Mikrocontroller-net/transistortester/Hardware/ArduinoUno_shield/ArduinoUno_TTshield_back.JPG

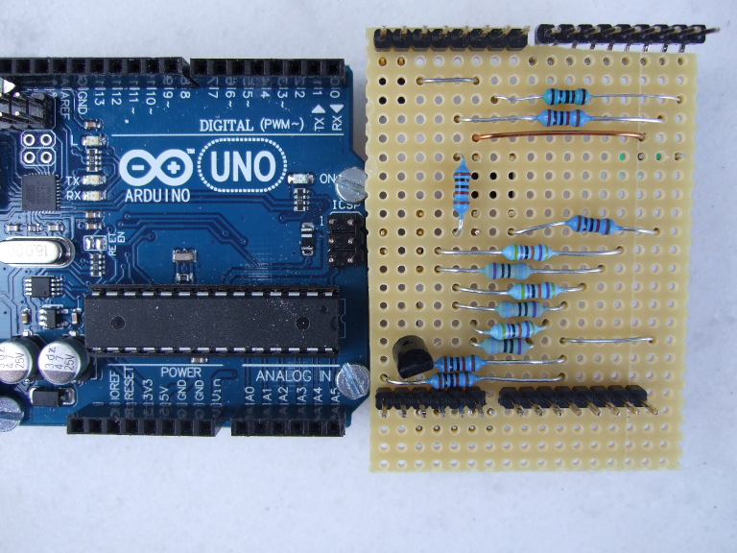
Hardware/ArduinoUno_shield/ArduinoUno_TTshield_back.JPG
