Mikrocontroller-net/transistortester/Hardware/ArduinoUno_shield/ArduinoUno_TTshield_front.JPG

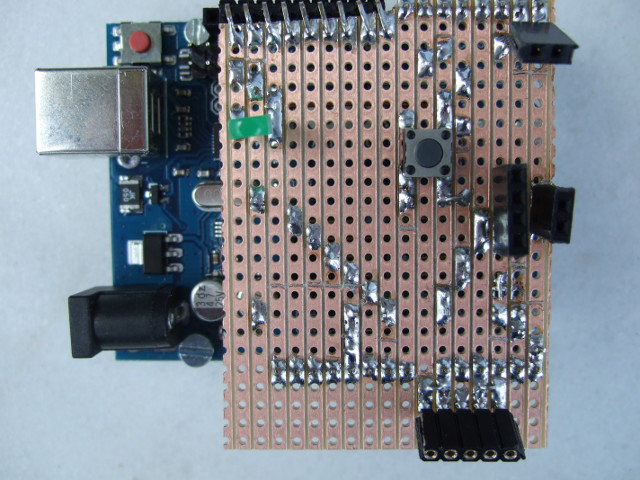
Hardware/ArduinoUno_shield/ArduinoUno_TTshield_front.JPG
