Mikrocontroller-net/transistortester/Doku/tags/README.md

All old documentation files are removed here!

You can find them now at github.com/kubi48/TransistorTester-old-versions !
