Mikrocontroller-net/transistortester/Hardware/Max/LiesMich.txt

Ich habe mit Fritzing ein einseitiges Platinenlayout erstellt und mir 
eine Platine geätzt. Nachdem das ganze jetzt tadellos funktioniert 
wollte ich das anderen Anfängern gerne zugänglich machen. Wenn das 
gewünscht ist darf es natürlich auch gerne in das SVN aufgenommen 
werden.

Q1 ist lediglich ein Platzhalter für die Spannungsreferenz, die fritzing 
nicht kannte.

Gruß Max
