Mikrocontroller-net/transistortester/Software/trunk/mega168_3.3V/LiesMich.txt

Diese Konfiguration ist vorgesehen für die ATmega168 Version
des Testers mit DC-DC Converter-Betrieb aus einem LiIon Akkumulator.
Die untere Spannungsgrenze von 3.3V sollte einen Defekt des Akkus
durch Tiefentladung verhindern!
Als Anzeige wird ein 2x16 Zeichen Textdisplay verwendet.
Die Schaltung wurde von Funkamateuren im Rahmen des Fichtenfieldday 2013
entwickelt (http://www.o28.sischa.net/fifiprojekte/44-mini-bauteiltester).
