Mikrocontroller-net/transistortester/Software/picture-link.pdf

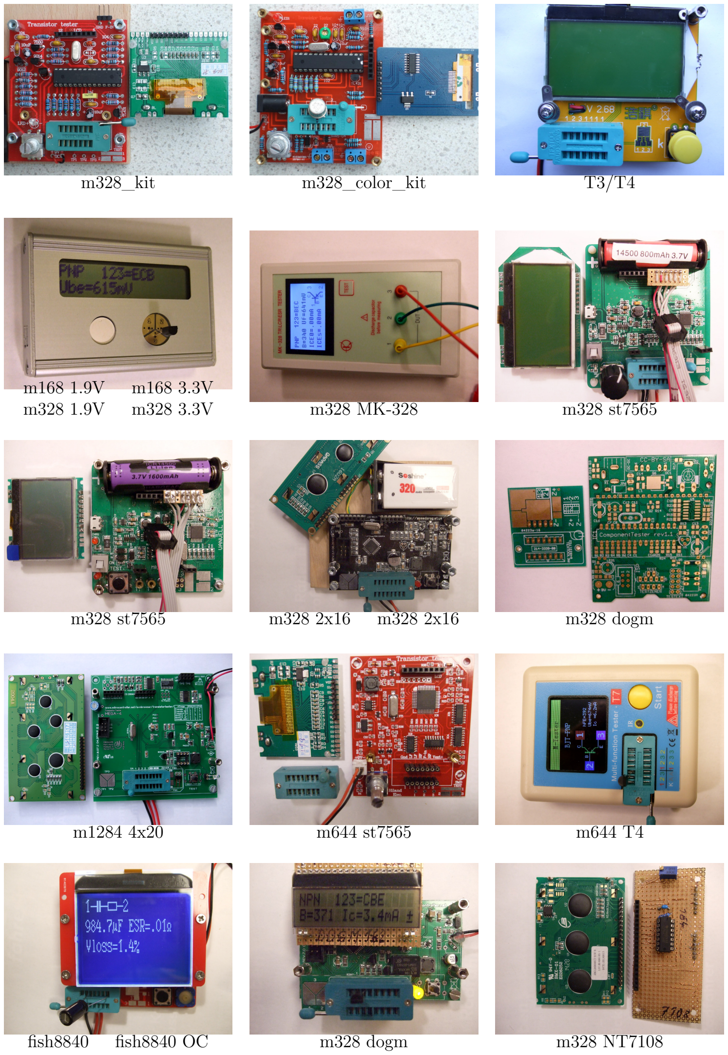
[picture p3: page 1]

m328_kit | m328_color_kit | T3/T4
m168 1.9V | m168 3.3V
m328 1.9V | m328 3.3V | m328 MK-328 | m328 st7565
m328 st7565 | m328 2x16 | m328 2x16 | m328 dogm
m1284 4x20 | m644 st7565 | m644 T4
fish8840 | fish8840 OC | m328 dogm | m328 NT7108
