Mikrocontroller-net/transistortester/Software/trunk/mega168_strip_grid/LiesMich.txt

Achtung, diese Version aktiviert eine andere Pinbelegung für den Anschluss des LC-Displays.
Auf keinen Fall für eine Leiterplatte mit Standard-Belegung der Port D Pins benutzen!
