Mikrocontroller-net/transistortester/Hardware/Max/fritzing_diagram.png

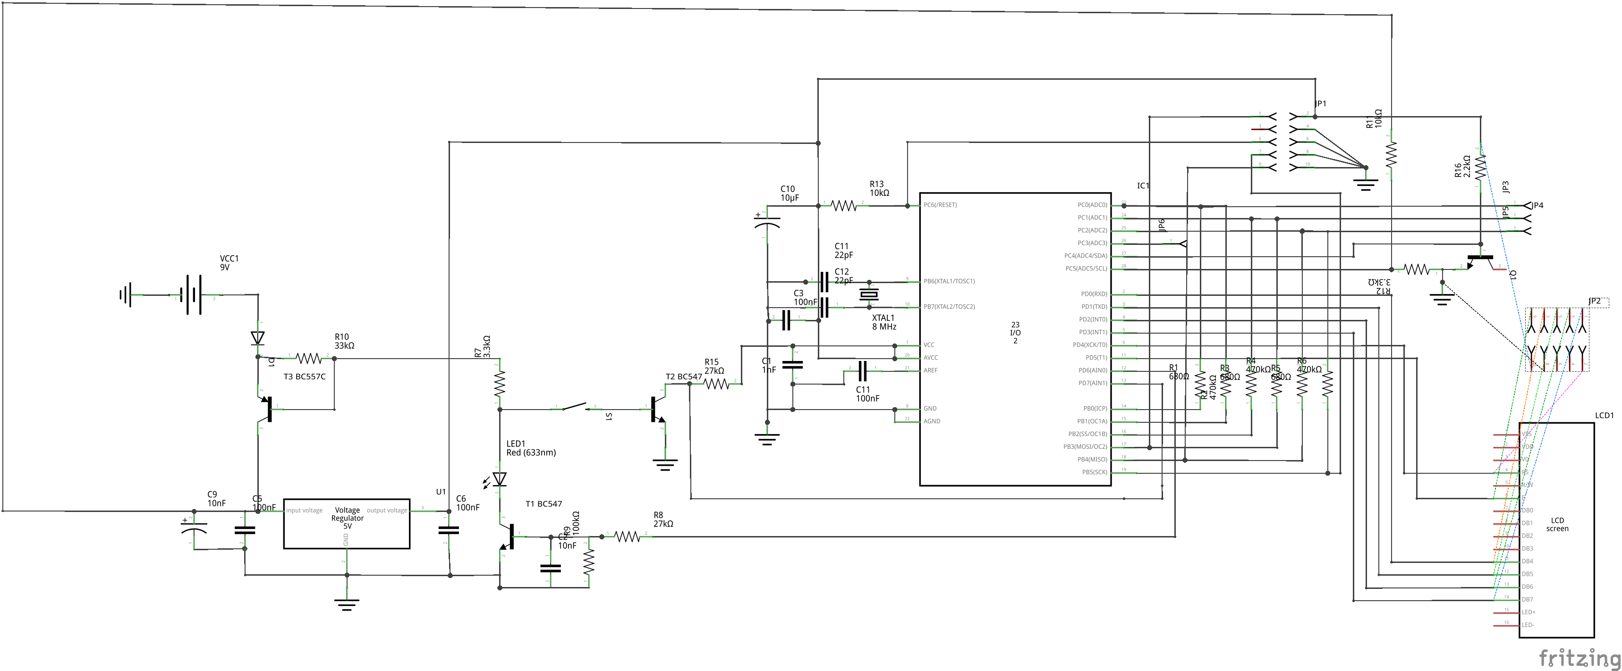
Hardware/Max/fritzing_diagram.png
