Mikrocontroller-net/transistortester/Hardware/PCB_mega328_ST7735/pcb AVR-Transistor tester.pdf

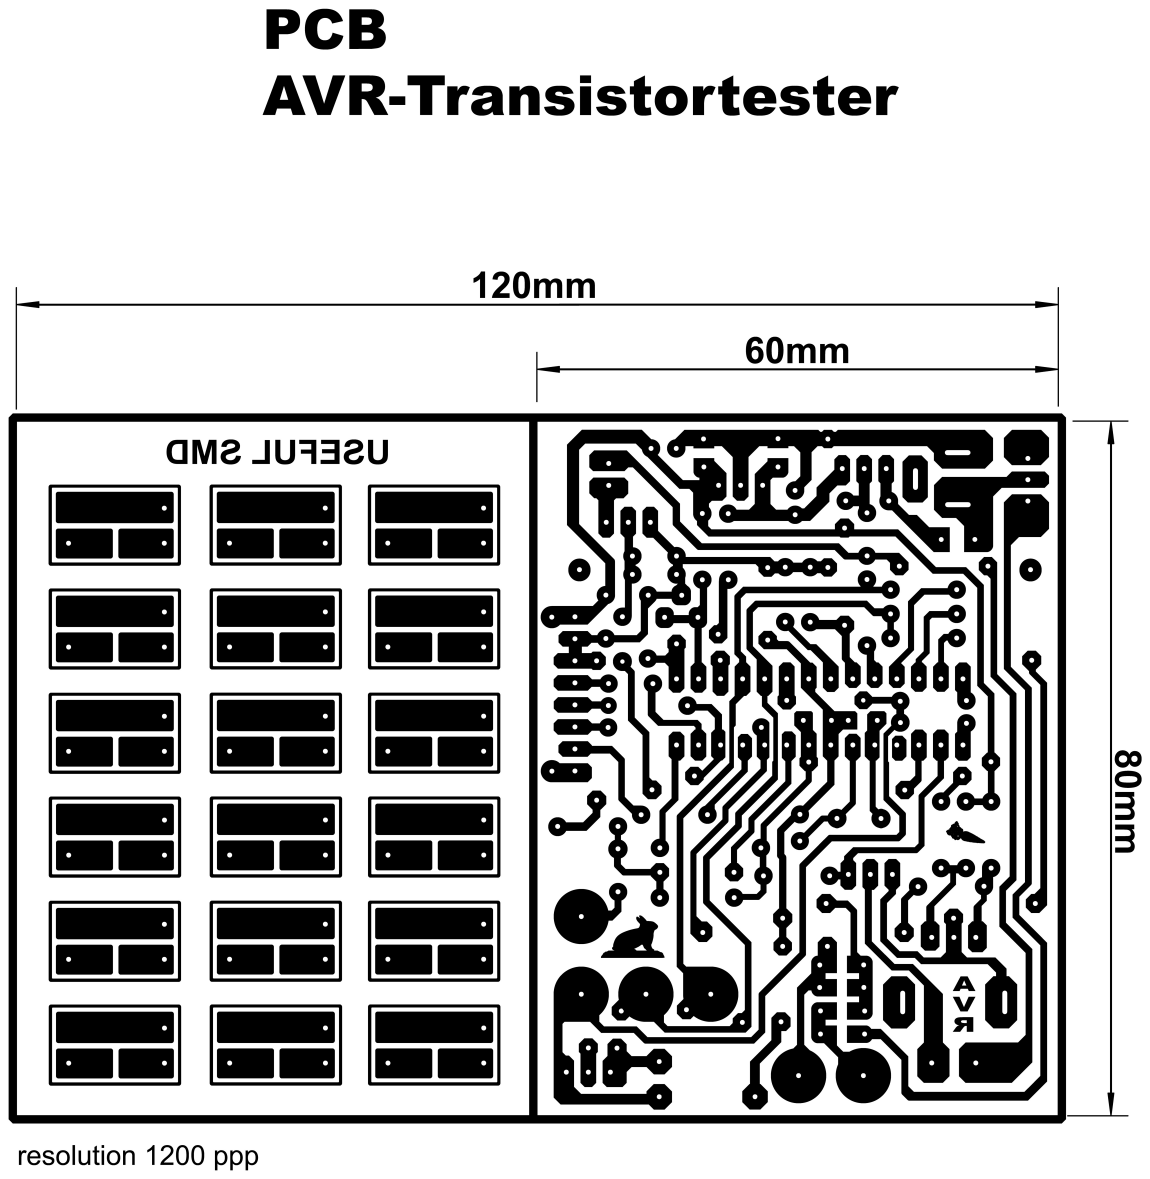
[picture p227: page 1]
