Mikrocontroller-net/transistortester/(threads)

Thread 2 (2021-05-07):

Guide for noob

0x0L, 2021-05-07:
Hello,

Thanks for this cool project!

I recently bought an LCR T4 and was really hopping to be able to upgrade the firmware using an Arduino Nano.
Is this something that's do-able or do I need some other card or even a dedicated usb programmer ?

Many thanks

kubi48, 2021-05-07:
Hallo,

there are two versions of this T4 tester that differ in the display connection.

You can find precompiled hex and eep files in the

directories Software/trunk/mega328_T3_T4_st7565 and Software/trunk/Mega328_T4_v2_st7565.

Of course you can use a Arduino Nano or Arduino UNO to update the T4 Tester with the

ISP-Programmer sample application.

But you can use also a USBASP AVR programmer  with a 10pin to 6-pin adapter or a

Pololu USB AVR Programmer, which has a additional USB-serial interface at the

same board.

Please note, that the standard configuration of the open source Software enables

the SamplingADC feature of Pieter-Tjerk.

With that feature the tester can measure small coils too,

if you connect a capacitor (10nf - 30nF) parallel to build a resonant circuit.

For this purpose, the calibration process was expanded to include the measurement of this capacitor.

Please use a high quality capacitor for this feature (low inductance capacitor)

to get proper inductance measurements.

There are some helpfull scripts too install the Transistortester Software

with Linux (tested with Linux Mint) at

github.com/kubi48/TransistorTester-Linux-install

Best regards,

Kark-Heinz

Gesendet: Freitag, 07. Mai 2021 um 12:41 Uhr
Von: "nullptr" ***@***.***>
An: "Mikrocontroller-net/transistortester" ***@***.***>
Cc: "Subscribed" ***@***.***>
Betreff: [Mikrocontroller-net/transistortester] Guide for noob (#2)

Hello,

Thanks for this cool project!

I recently bought an LCR T4 and was really hopping to be able to upgrade the firmware using an Arduino Nano.
Is this something that's do-able or do I need some other card or even a dedicated usb programmer ?

Many thanks

—
You are receiving this because you are subscribed to this thread.
Reply to this email directly, view it on GitHub, or unsubscribe.

0x0L, 2021-05-07:
Thank you very much for your answers!
Best regards

Closed 2021-05-07.

Thread 5 (2021-08-03):

Menu exit time

zhqsoft, 2021-08-03:
How to modify the auto exit waiting time under the menu interface? Now it takes 1400 seconds. It's too long. I didn't find the relevant settings in the source code.

pav1388, 2021-08-03:
File function_menu.c
Find ii = wait_for_key_ms(SHORT_WAIT_TIME);
Replace ii = wait_for_key_ms(200);
It turns out about 30 seconds.  Two years ago it definitely worked.

zhqsoft, 2021-08-03:
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

非常感谢，已经成功了。替换成200，无操作1分钟自动退出

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

Thank you very much. It has been successful. Replace with 200 and exit automatically after 1 minute without operation。

zhqsoft, 2021-08-03:
200 will lead to abnormal key function. It takes at least 1000, but it takes too long

Thread 8 (2022-12-08):

How i can get an negative picture on LCR-T4

porlock, 2022-12-08:
I switch a screen on my LCR-T4 to blue backlight one, but black letters on blue background are almost invisible :( is there a way how i can make a display in negative ?
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

kubi48, 2022-12-10:
Hello Tomasz,

There is no way supported by the "k" software version, that the pixels

 of  the display can be shown inverted.

Probably you can try to find a better contrast value in the menu (Contrast).

But you should know, that the contrast value is decreased by a short key press

and increased by a longer (>0.5 s) key press. A very long key press will save the value.

If the contrast value is changed to a wrong value, the content of the display is unvisible!

Sometimes the content is visible with a look from the side to the display.

Otherwise you can try to press the key many times with short presses to get a visible

value. If a wrong value is saved by the very long key press, there is no way to read the

menu again. You must reprogram the ATmega to reset the contrast value to the default value.

You can also change the start value in the Makefile (CFLAGS += -DVOLUME_VALUE=48)

and recompile the software.

Best regards,

Karl-Heinz

Gesendet: Donnerstag, 08. Dezember 2022 um 18:21 Uhr
Von: "Tomasz Zieliński" ***@***.***>
An: "Mikrocontroller-net/transistortester" ***@***.***>
Cc: "Subscribed" ***@***.***>
Betreff: [Mikrocontroller-net/transistortester] How i can get an negative picture on LCR-T4 (Issue #8)

I switch a screen on my LCR-T4 to blue backlight one, but black letters on blue background are almost invisible :( is there a way how i can make a display in negative ?

—
Reply to this email directly, view it on GitHub, or unsubscribe.
You are receiving this because you are subscribed to this thread.Message ID: ***@***.***>

Thread 10 (2023-06-21):

Use avr-gcc built-in F_CPU instead of custom OP_MHZ option

powerbroker, 2023-06-21:
with built-in F-CPU value OP_MHZ can be easily calculated as 'F_CPU / 1000000' and is redundant as a separate setting.

just replace it with F_CPU so user has less headache when configures CPU frequency.

Thread 9 (2023-06-21):

Separate project configuration and build system

powerbroker, 2023-06-21:
there are configuration subfolders in the /transistortester/software/trunk, e.g. 'mega328_MK-328', 'mega644_LCD2004' and so on, containing 'Makefile', specific for each configuration.
there are lots of configuration settings in the config-specific 'Makefile's, and a short build procedure definition. the most of settings are in form of compiler flags, defining macros.

it's extremely hard to enforce proper code assistance and to build project from sources within IDE(with it's own build procedure).

would be great to have configuration setting inside some header file, like default "avr/io.h" is done. depending on project's 'MCU Type' it includes corresponding IO definition header, e.g. 'avr/iom328p.h' in case of 'ATmega328P' or 'ATmega328'.
this way, 'to build the project user just include e.g. 'config.h', which in case of 'st7565_kit' includes default 'st7565_kit.h', in case of 'GM328' - default 'gm328.h', in case of custom schematics - 'custom.h'

Thread 12 (2023-06-22):

Support PCF8814-based Nokla 1110i LCD

powerbroker, 2023-06-22:
Nokla 1110i LCD connected as following:
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

code compiled with 'WITH_LCD_ST7565 = 8814' and 'LCD_INTERFACE_MODE=3'.

to force the LCD to work finally, void lcd_init() in lcd-routines.c muzz be patched(changes marked with 'Nokla-1110i support' comment):

`#elif (LCD_ST_TYPE == 8814)
   uint8_t volume;

   //Nokla-1110i support
   HW_LCD_CE_PORT &=~(1<<HW_LCD_CE_PIN); 		// CS => 0
   HW_LCD_RES_PORT &=~(1<<HW_LCD_RES_PIN);	// RST => 0
   wait_about10ms();							// wait 5ms or may fail
   HW_LCD_RES_PORT|=(1<<HW_LCD_RES_PIN);		// RST => 1

   lcd_command(0xE2);							// CMD_INTERNAL_RESET
   wait_about50ms();
   //END-OF Nokla-1110i support

   volume = eeprom_read_byte(&EE_Volume_Value);		// read Vop
   lcd_command(CMD_SET_VOP_UPPER | ((volume >> 5) & 0x07));	// set upper Vop
   lcd_command(CMD_SET_VOP_LOWER | (volume & 0x1f));	// set lower Vop
   lcd_command(CMD_SET_START_LINE | (LCD_ST7565_Y_START & 0x3f));       // Set the Start line 0
   lcd_command(CMD_SET_ALLPTS_NORMAL);		// 0xa4 set display to normal

   //Nokla-1110i support
   //lcd_command(CMD_SET_POWER_CONTROL | 4);	// 0x28|4 Charge Pump ON
   lcd_command(CMD_SET_POWER_CONTROL | 7);	// 0x2F !!! Charge Pump ON
   lcd_command(CMD_SET_START_LINE | (LCD_ST7565_Y_START & 0x3f));       // 0x40 Set the Start line 0
   //END-OF Nokla-1110i support

   lcd_command(CMD_SET_COM_REVERSE);		// 0xc8
   lcd_command(CMD_SET_COM_NORMAL);		// 0xc0 set normal Y orientation
   lcd_command(0xa1);				// set MX, X orientation, is pad selectet!
   lcd_command(0xaa);				// set horizontal mode
   lcd_command(0xac);				// set initial row
   lcd_command(0x08);				// initial row = 8  (0-7)
   lcd_clear();
   lcd_command(CMD_DISPLAY_ON);			// 0xaf Display on
   lcd_set_cursor(0,0);`

Thread 13 (2023-10-30):

XTAL not compiling

wrobeleczek, 2023-10-30:
Project: mega328_color_kit
After enabling flag DWITH_XTAL and setting OP MHZ = 16 and WITH_SamplingADC = 1, compilation fails with error:
/usr/lib/gcc/avr/5.4.0/../../../avr/bin/ld: ../Obj/mega328_color_kit/mega328_color_kit.elf section `.text' will not fit in region `text'
/usr/lib/gcc/avr/5.4.0/../../../avr/bin/ld: region `text' overflowed by 1706 bytes

Would You like to tell me it is bug or I do someting wrong?

kubi48, 2023-10-31:
Probably you use a too old avr-gcc compiler.

You can check your compiler version with the command:

avr-gcc -v

The compiler must optimize the code very well to fit this configuration (color-display).

Please make shure, that you use the avr-gcc with version 7.3.0 !

You can find this compiler at:

www.microchip.com/en-us/tools-resources/develop/microchip-studio/gcc-compilers

Best regards,

Karl-Heinz

Gesendet: Montag, 30. Oktober 2023 um 18:56 Uhr
Von: "wrobeleczek" ***@***.***>
An: "Mikrocontroller-net/transistortester" ***@***.***>
Cc: "Subscribed" ***@***.***>
Betreff: [Mikrocontroller-net/transistortester] XTAL not compiling (Issue #13)

Project: mega328_color_kit
After enabling flag DWITH_XTAL and setting OP MHZ = 16 and WITH_SamplingADC = 1, compilation fails with error:
/usr/lib/gcc/avr/5.4.0/../../../avr/bin/ld: ../Obj/mega328_color_kit/mega328_color_kit.elf section .text' will not fit in region text'
/usr/lib/gcc/avr/5.4.0/../../../avr/bin/ld: region `text' overflowed by 1706 bytes

Would You like to tell me it is bug or I do someting wrong?

—
Reply to this email directly, view it on GitHub, or unsubscribe.
You are receiving this because you are subscribed to this thread.Message ID: ***@***.***>

Ho-Ro, 2023-10-31:
> Please make shure, that you use the avr-gcc with version 7.3.0 !

You can also use version `8.3.0` - see my [comparison of different versions](https://www.eevblog.com/forum/testgear/$20-lcr-esr-transistor-checker-project/msg5054215/#msg5054215).

Do not compile the toolchain on your own, `7.3.0` comes with the Arduino 1.x download for Linux and you can download the `8.3.0` binaries for Linux from
[ZakKemble's github](https://github.com/ZakKemble/avr-gcc-build/releases), especially from this link:
- [avr-gcc-8.3.0-x64-linux.tar.bz2](https://github.com/ZakKemble/avr-gcc-build/releases/download/v8.3.0-1/avr-gcc-8.3.0-x64-linux.tar.bz2)

You can also use the latest 13.2.0, it compiles much smaller again after the byte-hogs 9.x.y ... 12.x.y.
- [avr-gcc-13.2.0-1.fc38.x86_64.rpm](https://dl.fedoraproject.org/pub/fedora/linux/updates/38/Everything/x86_64/Packages/a/avr-gcc-13.2.0-1.fc38.x86_64.rpm)

I installed them locally for my user; I untarred the `8.3.0-*.tar.bz2` version and opened the `13.2.0-*.rpm` with the `mc` and copied the files into directories under my home dir, i.e. `~/.local/avr-gcc/avr-gcc-8.3.0` and `~/.local/avr-gcc/avr-gcc-13.2.0` and made softlinks from the avr-gcc binaries to `~/.local/bin/avr-gcc-8` and `~/.local/bin/avr-gcc-13`.

Then you can easily build with different version, just edit the `Makefile`.

HTH
Martin

wrobeleczek, 2023-10-31:
Hi Martin.
Could you tell me exactly which avr-gcc binaries I can add softlinks to?

kubi48, 2023-11-01:
I did unpack the avr8-gnu-toolchain-3.7.0.1796-linux.any.x86_64.tar.gz file

to my home directory ( /home/kub in my case).

After unpacking the avr-gcc is in /home/kub/avr8-gnu-toolchain-linux_x86_64/bin directory.

To replace the standard avr-gcc I have first removed the original compiler with:

sudo rm /usr/bin/avr-gcc

Don't worry about this remove because the same content is in /usr/bin/avr-gcc-5.4.0 .

Then I have installed a softlink to the new compiler:

sudo ln -s /home/kub/avr8-gnu-toolchain-linux_x86_64/bin/avr-gcc /usr/bin/avr-gcc

Of course, You must replace the /home/kub with your home directory name.

This trick works without problems.

Best regards,

Karl-Heinz

Gesendet: Dienstag, 31. Oktober 2023 um 18:03 Uhr
Von: "wrobeleczek" ***@***.***>
An: "Mikrocontroller-net/transistortester" ***@***.***>
Cc: "Karl-Heinz Kübbeler" ***@***.***>, "Comment" ***@***.***>
Betreff: Re: [Mikrocontroller-net/transistortester] XTAL not compiling (Issue #13)

Hi.
Your advice is probably correct (my gcc version 5.4.0 (GCC)).
I downloaded toolchain-avr-master and tried compiled but my knowledge is poor, very poor (like my english, I'm very sorry).
Olny this:
tools.bash
binutils.build.bash
gcc.build.bash
avr-libc.build.bash
compiled OK without fail.
gdb.build.bash -> unfortunately not finished good.
I tried read informations of compilation and noticed:

	checking for python2.7... no
	configure: WARNING: python is missing or unusable; some features may be unavailable
	but:
	whereis python2.7
	python2.7: /usr/bin/python2.7 /usr/lib/python2.7 /etc/python2.7 /usr/local/lib/python2.7 /usr/include/python2.7 /usr/share/man/man1/python2.7.1.gz
	python2.7
	Python 2.7.18 (default, Jul 1 2022, 10:30:50)
	[GCC 11.2.0] on linux2

	hecking whether to use guile... guile-2.0
	checking for pkg-config... /usr/bin/pkg-config
	checking for usable guile from /usr/bin/pkg-config... configure: error: unable to find usable guile version from "guile-2.0"
	make[1]: *** [Makefile:9610: configure-gdb] Fail 1
	but:
	whereis guile
	guile: /usr/bin/guile /usr/lib/x86_64-linux-gnu/guile /usr/share/guile
	GNU Guile 2.0.13
	My OS is Linux Mint 21.2
	Unfortunately, I can't cope with these problems. I don't even know if these errors caused the compilation to fail.

—
Reply to this email directly, view it on GitHub, or unsubscribe.
You are receiving this because you commented.Message ID: ***@***.***>

wrobeleczek, 2023-11-01:
Hi.
In my OS -> echo $PATH
/home/wrobel/.local/bin:/usr/local/sbin:/usr/local/bin:/usr/sbin:/usr/bin:/sbin:/bin:/usr/games:/usr/local/games:/snap/bin

~/.local/bin$ ls -l avr-*
-rwxr-xr-x 1 wrobel wrobel   569352 maj 11  2022 avr-addr2line
-rwxr-xr-x 1 wrobel wrobel   593248 maj 11  2022 avr-ar
-rwxr-xr-x 1 wrobel wrobel   778776 maj 11  2022 avr-as
-rwxr-xr-x 2 wrobel wrobel   920392 maj 11  2022 avr-c++
-rwxr-xr-x 1 wrobel wrobel   567896 maj 11  2022 avr-c++filt
-rwxr-xr-x 1 wrobel wrobel   916296 maj 11  2022 avr-cpp
-rwxr-xr-x 1 wrobel wrobel    24912 maj 11  2022 avr-elfedit
-rwxr-xr-x 2 wrobel wrobel   920392 maj 11  2022 avr-g++
-rwxr-xr-x 2 wrobel wrobel   916296 maj 11  2022 avr-gcc
-rwxr-xr-x 1 wrobel wrobel  1016712 sie 29 02:00 avr-gcc-13.2.0
-rwxr-xr-x 2 wrobel wrobel   916296 maj 11  2022 avr-gcc-7.3.0
-rwxr-xr-x 1 wrobel wrobel    23488 maj 11  2022 avr-gcc-ar
-rwxr-xr-x 1 wrobel wrobel    23456 maj 11  2022 avr-gcc-nm
-rwxr-xr-x 1 wrobel wrobel    23456 maj 11  2022 avr-gcc-ranlib
-rwxr-xr-x 1 wrobel wrobel   549608 maj 11  2022 avr-gcov
-rwxr-xr-x 1 wrobel wrobel   451488 maj 11  2022 avr-gcov-dump
-rwxr-xr-x 1 wrobel wrobel   475136 maj 11  2022 avr-gcov-tool
-rwxr-xr-x 1 wrobel wrobel  5148528 maj 11  2022 avr-gdb
-rwxr-xr-x 1 wrobel wrobel   623640 maj 11  2022 avr-gprof
-rwxr-xr-x 2 wrobel wrobel  1015096 maj 11  2022 avr-ld
-rwxr-xr-x 2 wrobel wrobel  1015096 maj 11  2022 avr-ld.bfd
-rwxr-xr-x 1 wrobel wrobel 23843136 sie 29 02:00 avr-lto-dump
-rwxr-xr-x 1 wrobel wrobel     1908 maj 11  2022 avr-man
-rwxr-xr-x 1 wrobel wrobel   581112 maj 11  2022 avr-nm
-rwxr-xr-x 1 wrobel wrobel   727512 maj 11  2022 avr-objcopy
-rwxr-xr-x 1 wrobel wrobel   836104 maj 11  2022 avr-objdump
-rwxr-xr-x 1 wrobel wrobel   593264 maj 11  2022 avr-ranlib
-rwxr-xr-x 1 wrobel wrobel   415736 maj 11  2022 avr-readelf
-rwxr-xr-x 1 wrobel wrobel   581688 maj 11  2022 avr-size
-rwxr-xr-x 1 wrobel wrobel   572296 maj 11  2022 avr-strings
-rwxr-xr-x 1 wrobel wrobel   727512 maj 11  2022 avr-strip

# compiler flags
CC = avr-gcc-13.2.0
###CPP = avr-g++
OBJCOPY = avr-objcopy-13
OBJDUMP = avr-objdump-13
SIZE = avr-size-13

After compilations:
~/transistortester-master/Software/trunk/mega328_color_kit$ make
rm -rf ../Obj/mega328_color_kit
mkdir -p ../Obj/mega328_color_kit
mkdir -p ../Obj/mega328_color_kit/dep
avr-gcc-13.2.0  -Wall -DWITH_MENU -DWITH_ROTARY_SWITCH=2 -DFOUR_LINE_LCD -DLCD_SCREEN_ROTATE=1 -DLCD_ST7565_H_FLIP=0 -DLCD_ST7565_H_OFFSET=0 -DLCD_ST7565_V_FLIP=1 -DLCD_CHANGE_COLOR=2 -DLCD_BG_COLOR=0x7800 -DLCD_FG_COLOR=0xffff -DLCD_ICON_COLOR=0x03ff -DFONT_8X16thin -DICON_TYPE=3 -DBIG_TP -DWITH_SELFTEST -DAUTO_CAL -DSHORT_UNCAL_MSG -DWITH_XTAL -DWITH_UJT -DWITH_PUT -DFET_Idss -DWITH_AUTO_REF -DREF_C_KORR=12 -DREF_L_KORR=40 -DC_H_KORR=0 -DWITH_VEXT -DRMETER_WITH_L -DCAP_EMPTY_LEVEL=4 -DAUTOSCALE_ADC -DREF_R_KORR=3 -DESR_ZERO=20 -DNO_AREF_CAP -DUSE_EEPROM -DPULLUP_DISABLE -DANZ_MESS=25 -DPOWER_OFF -DBAT_CHECK -DBAT_OUT=150 -DBAT_POOR=6400 -DBAT_NUMERATOR=133 -DBAT_DENOMINATOR=33 -mcall-prologues -I. -DLANG_POLISH -DLCD_ST_TYPE=7735 -DF_CPU=16000000UL -DF_CPU_HZ=16000000 -DMHZ_CPU=16 -mmcu=atmega328p -gdwarf-2 -std=gnu99 -Os -funsigned-char -funsigned-bitfields -fpack-struct -fshort-enums -MD -MP -MT lcd_hw_4_bit.o -MF ../Obj/mega328_color_kit/dep/lcd_hw_4_bit.o.d  -ffunction-sections -fdata-sections -DSamplingADC -c -o ../Obj/mega328_color_kit/lcd_hw_4_bit.o ../lcd_hw_4_bit.S
../lcd_hw_4_bit.S:6:10: fatal error: avr/io.h: No such file or directory
    6 | #include <avr/io.h>
      |          ^~~~~~~~~~
compilation terminated.
make: *** [../finish.mk:14: ../Obj/mega328_color_kit/lcd_hw_4_bit.o] Fail 1

Ho-Ro, 2023-11-01:
Do not *copy* the binaries, just make a softlink to the binaries, (`ln -s ../.../avr-gcc .`) because the `includes` are searched relative to the binaries. Compare your`.local/bin` and mine!

wrobeleczek, 2023-11-02:
Hi.
Now, I understand my mistakes.
The Compilation ends successful.
But when I send .hex to m328p have this:
avrdude -c usbasp -p m328p -U flash:w:mega328_color_kit.hex
avrdude: warning: cannot set sck period. please check for usbasp firmware update.
avrdude: AVR device initialized and ready to accept instructions

Reading | ################################################## | 100% 0.00s

avrdude: Device signature = 0x1e950f (probably m328p)
avrdude: NOTE: "flash" memory has been specified, an erase cycle will be performed
         To disable this feature, specify the -D option.
avrdude: erasing chip
avrdude: warning: cannot set sck period. please check for usbasp firmware update.
avrdude: reading input file "mega328_color_kit.hex"
avrdude: input file mega328_color_kit.hex auto detected as Intel Hex
avrdude: ERROR: address 0x8010 out of range at line 2049 of mega328_color_kit.hex
avrdude: read from file 'mega328_color_kit.hex' failed
avrdude: safemode: Fuses OK (E:FC, H:D9, L:F7)

avrdude done.  Thank you.

When I comment "XTAL" then I can send .hex, .eep without any error.
I noticed:
**(without XTAL)**
16 MHz operation configured.
AVR Memory Usage
----------------
Device: atmega328p
Program:   31952 bytes (97.5% Full)
(.text + .data + .bootloader)
Data:        204 bytes (10.0% Full)
(.data + .bss + .noinit)
EEPROM:      890 bytes (86.9% Full)
(.eeprom)

**(whit XTAL)**
16 MHz operation configured.
AVR Memory Usage
----------------
Device: atmega328p
Program:   34416 bytes (105.0% Full)
(.text + .data + .bootloader)
Data:        212 bytes (10.4% Full)
(.data + .bss + .noinit)
EEPROM:      930 bytes (90.8% Full)
(.eeprom)

Ho-Ro, 2023-11-02:
> The Compilation ends successful.

No!

> Program: 34416 bytes (105.0% Full)

Your resulting hex is too big for the processor- you should omit some other features.

wrobeleczek, 2023-11-02:
What I meant was that the compilation finished correctly (without any previous errors).
So we're back to the beginning.
Apparently, it remains to disable XTAL. :(
My features:
PROJECT = mega328_color_kit
CC = avr-gcc
OBJCOPY = avr-objcopy-13
OBJDUMP = avr-objdump-13
SIZE = avr-size-13
CFLAGS = -Wall
PARTNO = m328p
CFLAGS += -DWITH_MENU
CFLAGS += -DWITH_ROTARY_SWITCH=2
UI_LANGUAGE = LANG_ENGLISH
CFLAGS += -DFOUR_LINE_LCD
WITH_LCD_ST7565 = 7735
LCD_ST7565_RESISTOR_RATIO = 4
CFLAGS += -DLCD_SCREEN_ROTATE=1
CFLAGS += -DLCD_ST7565_H_FLIP=0
CFLAGS += -DLCD_ST7565_H_OFFSET=0
CFLAGS += -DLCD_ST7565_V_FLIP=1
CFLAGS += -DLCD_CHANGE_COLOR=2
CFLAGS += -DLCD_BG_COLOR=0x7800
CFLAGS += -DLCD_FG_COLOR=0xffff
CFLAGS += -DLCD_ICON_COLOR=0x03ff
CFLAGS += -DFONT_8X16thin
CFLAGS += -DICON_TYPE=3
CFLAGS += -DBIG_TP
CFLAGS += -DBIG_TP
CFLAGS += -DAUTO_CAL
CFLAGS += -DSHORT_UNCAL_MSG
WITH_SamplingADC = 1
CFLAGS += -DWITH_XTAL
CFLAGS += -DFET_Idss
CFLAGS += -DWITH_AUTO_REF
CFLAGS += -DREF_C_KORR=12
CFLAGS += -DREF_L_KORR=40
CFLAGS += -DC_H_KORR=0
CFLAGS += -DWITH_VEXT
CFLAGS += -DRMETER_WITH_L
CFLAGS += -DCAP_EMPTY_LEVEL=4
CFLAGS += -DAUTOSCALE_ADC
CFLAGS += -DREF_R_KORR=3
CFLAGS += -DESR_ZERO=20
CFLAGS += -DNO_AREF_CAP
OP_MHZ = 16
CFLAGS += -DUSE_EEPROM
CFLAGS += -DPULLUP_DISABLE
CFLAGS += -DANZ_MESS=25
CFLAGS += -DPOWER_OFF
CFLAGS += -DBAT_CHECK
CFLAGS += -DBAT_OUT=150
CFLAGS += -DBAT_POOR=6400
CFLAGS += -DBAT_NUMERATOR=133
CFLAGS += -DBAT_DENOMINATOR=33
INHIBIT_SLEEP_MODE = 0
PROGRAMMER=usbasp
BitClock=20
PORT=usb
PROGRAMMER=usbasp
include ../setup.mk
$(OBJDIR)/GetRLmultip.o: ../GetRLmultip.S $(MKFILES)
        $(CC) $(INCLUDES) $(CFLAGS) -c -o $@ $<

$(OBJDIR)/UfAusgabe.o: ../UfAusgabe.S $(MKFILES)
        $(CC) $(INCLUDES) $(CFLAGS) -c -o $@ $<

$(OBJDIR)/RvalOut.o: ../RvalOut.S $(MKFILES)
        $(CC) $(INCLUDES) $(CFLAGS) -c -o $@ $<

$(OBJDIR)/PinLayout.o: ../PinLayout.S $(MKFILES)
        $(CC) $(INCLUDES) $(CFLAGS) -c -o $@ $<

$(OBJDIR)/RefVoltage.o: ../RefVoltage.S $(MKFILES)
        $(CC) $(INCLUDES) $(CFLAGS) -c -o $@ $<

$(OBJDIR)/i2lcd.o: ../i2lcd.S $(MKFILES)
        $(CC) $(INCLUDES) $(CFLAGS) -c -o $@ $<

$(OBJDIR)/ReadADC.o: ../ReadADC.S $(MKFILES)
        $(CC) $(INCLUDES) $(CFLAGS) -c -o $@ $<

$(OBJDIR)/sleep_5ms.o: ../sleep_5ms.S $(MKFILES)
        $(CC) $(INCLUDES) $(CFLAGS) -c -o $@ $<

$(OBJDIR)/wait_for_key_ms.o: ../wait_for_key_ms.c $(MKFILES)
        $(CC) $(INCLUDES) $(CFLAGS) -c -o $@ $<

$(OBJDIR)/get_log.o: ../get_log.S $(MKFILES)
        $(CC) $(INCLUDES) $(CFLAGS) -c -o $@ $<

include ../finish.mk
$(NAME): ${OBJECTS}
         ${CC} ${LDFLAGS} ${OBJECTS} ${LIBDIRS} ${LIBS} -o ${NAME}

# create hex file of firmware
%.hex: ${NAME}
        ${OBJCOPY} -O ihex ${HEX_FLASH_FLAGS} $< $@

# create hex file of EEPROM data
%.eep: ${NAME}
        -${OBJCOPY} ${HEX_EEPROM_FLAGS} -O ihex $< $@ || exit 0

# create dump of firmware
%.lss: ${NAME}
        ${OBJDUMP} -h -S $< > $@
# rule for all c-files
${OBJECTS_C}: %.o: %.c ${HEADERS} ${MAKEFILE_LIST}
        ${CC} ${CFLAGS} -c ${@:.o=.c}

# rule for all S-files
${OBJECTS_S}: %.o: %.S ${HEADERS} ${MAKEFILE_LIST}
        ${CC} ${CFLAGS} -c ${@:.o=.S}

When I comment:
CFLAGS += -DWITH_UJT
CFLAGS += -DWITH_PUT
.....
AVR Memory Usage
----------------
Device: atmega328p
Program:   33786 bytes (103.1% Full) -> :(
(.text + .data + .bootloader)
Data:        212 bytes (10.4% Full)
(.data + .bss + .noinit)
EEPROM:      916 bytes (89.5% Full)
(.eeprom)
I don't know what else I can turn off. :(

kubi48, 2023-11-02:
You can Try to remove other features, if you wish to enable XTAL testing with the color display.

I suggest:

CFLAGS += -DNO_TEST_T1_T7

#CFLAGS += -DFET_Idss

If you need the tests T1 to T7 for functional test (error case),

you must deselect the "CFLAGS += -DWITH_XTAL" to

enable the "CFLAGS += -DNO_TEST_T1_T7" .

Otherwise you can try to use a smaller font like:

CFLAGS += -DFONT_6X8
#CFLAGS += -DFONT_8X12thin

Best regards,

Karl-Heinz

Gesendet: Donnerstag, 02. November 2023 um 21:08 Uhr
Von: "wrobeleczek" ***@***.***>
An: "Mikrocontroller-net/transistortester" ***@***.***>
Cc: "Karl-Heinz Kübbeler" ***@***.***>, "Comment" ***@***.***>
Betreff: Re: [Mikrocontroller-net/transistortester] XTAL not compiling (Issue #13)

What I meant was that the compilation finished correctly (without any previous errors).
So we're back to the beginning.
Apparently, it remains to disable XTAL. :(
My features:
PROJECT = mega328_color_kit
CC = avr-gcc
OBJCOPY = avr-objcopy-13
OBJDUMP = avr-objdump-13
SIZE = avr-size-13
CFLAGS = -Wall
PARTNO = m328p
CFLAGS += -DWITH_MENU
CFLAGS += -DWITH_ROTARY_SWITCH=2
UI_LANGUAGE = LANG_ENGLISH
CFLAGS += -DFOUR_LINE_LCD
WITH_LCD_ST7565 = 7735
LCD_ST7565_RESISTOR_RATIO = 4
CFLAGS += -DLCD_SCREEN_ROTATE=1
CFLAGS += -DLCD_ST7565_H_FLIP=0
CFLAGS += -DLCD_ST7565_H_OFFSET=0
CFLAGS += -DLCD_ST7565_V_FLIP=1
CFLAGS += -DLCD_CHANGE_COLOR=2
CFLAGS += -DLCD_BG_COLOR=0x7800
CFLAGS += -DLCD_FG_COLOR=0xffff
CFLAGS += -DLCD_ICON_COLOR=0x03ff
CFLAGS += -DFONT_8X16thin
CFLAGS += -DICON_TYPE=3
CFLAGS += -DBIG_TP
CFLAGS += -DBIG_TP
CFLAGS += -DAUTO_CAL
CFLAGS += -DSHORT_UNCAL_MSG
WITH_SamplingADC = 1
CFLAGS += -DWITH_XTAL
CFLAGS += -DFET_Idss
CFLAGS += -DWITH_AUTO_REF
CFLAGS += -DREF_C_KORR=12
CFLAGS += -DREF_L_KORR=40
CFLAGS += -DC_H_KORR=0
CFLAGS += -DWITH_VEXT
CFLAGS += -DRMETER_WITH_L
CFLAGS += -DCAP_EMPTY_LEVEL=4
CFLAGS += -DAUTOSCALE_ADC
CFLAGS += -DREF_R_KORR=3
CFLAGS += -DESR_ZERO=20
CFLAGS += -DNO_AREF_CAP
OP_MHZ = 16
CFLAGS += -DUSE_EEPROM
CFLAGS += -DPULLUP_DISABLE
CFLAGS += -DANZ_MESS=25
CFLAGS += -DPOWER_OFF
CFLAGS += -DBAT_CHECK
CFLAGS += -DBAT_OUT=150
CFLAGS += -DBAT_POOR=6400
CFLAGS += -DBAT_NUMERATOR=133
CFLAGS += -DBAT_DENOMINATOR=33
INHIBIT_SLEEP_MODE = 0
PROGRAMMER=usbasp
BitClock=20
PORT=usb
PROGRAMMER=usbasp
include ../setup.mk
$(OBJDIR)/GetRLmultip.o: ../GetRLmultip.S $(MKFILES)
$(CC) $(INCLUDES) $(CFLAGS) -c -o $@ $<

$(OBJDIR)/UfAusgabe.o: ../UfAusgabe.S $(MKFILES)
$(CC) $(INCLUDES) $(CFLAGS) -c -o $@ $<

$(OBJDIR)/RvalOut.o: ../RvalOut.S $(MKFILES)
$(CC) $(INCLUDES) $(CFLAGS) -c -o $@ $<

$(OBJDIR)/PinLayout.o: ../PinLayout.S $(MKFILES)
$(CC) $(INCLUDES) $(CFLAGS) -c -o $@ $<

$(OBJDIR)/RefVoltage.o: ../RefVoltage.S $(MKFILES)
$(CC) $(INCLUDES) $(CFLAGS) -c -o $@ $<

$(OBJDIR)/i2lcd.o: ../i2lcd.S $(MKFILES)
$(CC) $(INCLUDES) $(CFLAGS) -c -o $@ $<

$(OBJDIR)/ReadADC.o: ../ReadADC.S $(MKFILES)
$(CC) $(INCLUDES) $(CFLAGS) -c -o $@ $<

$(OBJDIR)/sleep_5ms.o: ../sleep_5ms.S $(MKFILES)
$(CC) $(INCLUDES) $(CFLAGS) -c -o $@ $<

$(OBJDIR)/wait_for_key_ms.o: ../wait_for_key_ms.c $(MKFILES)
$(CC) $(INCLUDES) $(CFLAGS) -c -o $@ $<

$(OBJDIR)/get_log.o: ../get_log.S $(MKFILES)
$(CC) $(INCLUDES) $(CFLAGS) -c -o $@ $<

include ../finish.mk
$(NAME): ${OBJECTS}
${CC} ${LDFLAGS} ${OBJECTS} ${LIBDIRS} ${LIBS} -o ${NAME}

create hex file of firmware

%.hex: ${NAME}
${OBJCOPY} -O ihex ${HEX_FLASH_FLAGS} $&lt; $@

create hex file of EEPROM data

%.eep: ${NAME}
-${OBJCOPY} ${HEX_EEPROM_FLAGS} -O ihex $&lt; $@ || exit 0

create dump of firmware

%.lss: ${NAME}
${OBJDUMP} -h -S $&lt; > $@

rule for all c-files

${OBJECTS_C}: %.o: %.c ${HEADERS} ${MAKEFILE_LIST}
${CC} ${CFLAGS} -c ${@:.o=.c}

rule for all S-files

${OBJECTS_S}: %.o: %.S ${HEADERS} ${MAKEFILE_LIST}
${CC} ${CFLAGS} -c ${@:.o=.S}

When I comment:
CFLAGS += -DWITH_UJT
CFLAGS += -DWITH_PUT
.....
AVR Memory Usage

Device: atmega328p
Program: 33786 bytes (103.1% Full) -> :(
(.text + .data + .bootloader)
Data: 212 bytes (10.4% Full)
(.data + .bss + .noinit)
EEPROM: 916 bytes (89.5% Full)
(.eeprom)
I don't know what else I can turn off. :(

—
Reply to this email directly, view it on GitHub, or unsubscribe.
You are receiving this because you commented.Message ID: ***@***.***>

wrobeleczek, 2023-11-02:
Hi Karl-Heinz.
I changed the font to 5x8 and... success!! :)
...
16 MHz operation configured.
AVR Memory Usage
----------------
Device: atmega328p
Program:   32692 bytes (99.8% Full)
(.text + .data + .bootloader)
Data:        212 bytes (10.4% Full)
(.data + .bss + .noinit)
EEPROM:      922 bytes (90.0% Full)
(.eeprom)

Thx for all. Very Thx.

wrobeleczek, 2023-11-02:
Additionally, I noticed that avr-gcc-8.3.0 has a smaller .hex and .eep file than avr-gcc-7.3.0.

Closed 2023-11-02.
