Mikrocontroller-net/transistortester/Hardware/ArduinoUno_shield/UNO_tester_shield.pdf

10K

## Finp

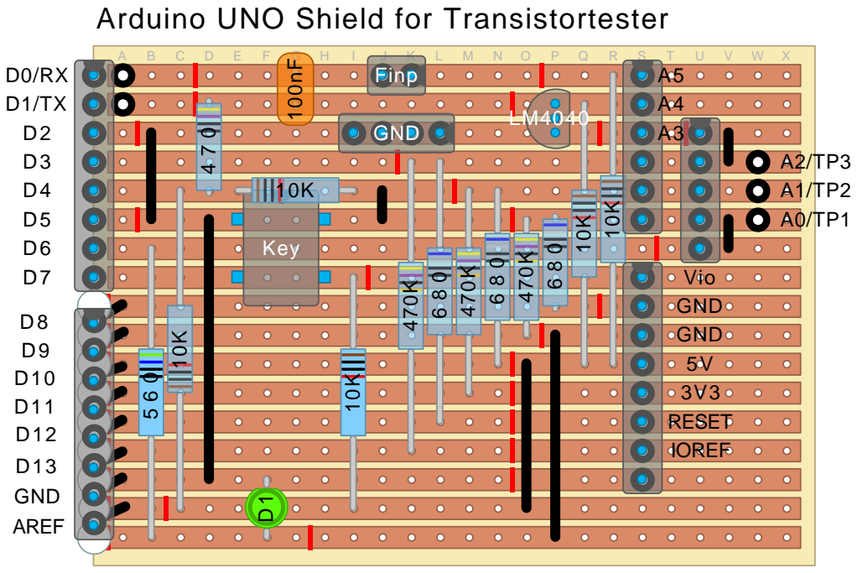
[picture p228: page 1]

Arduino UNO Shield for Transistortester
