Mikrocontroller-net/transistortester/Hardware/ArduinoUno_shield/UnoShield.pdf

# 10k¹⁰k 470

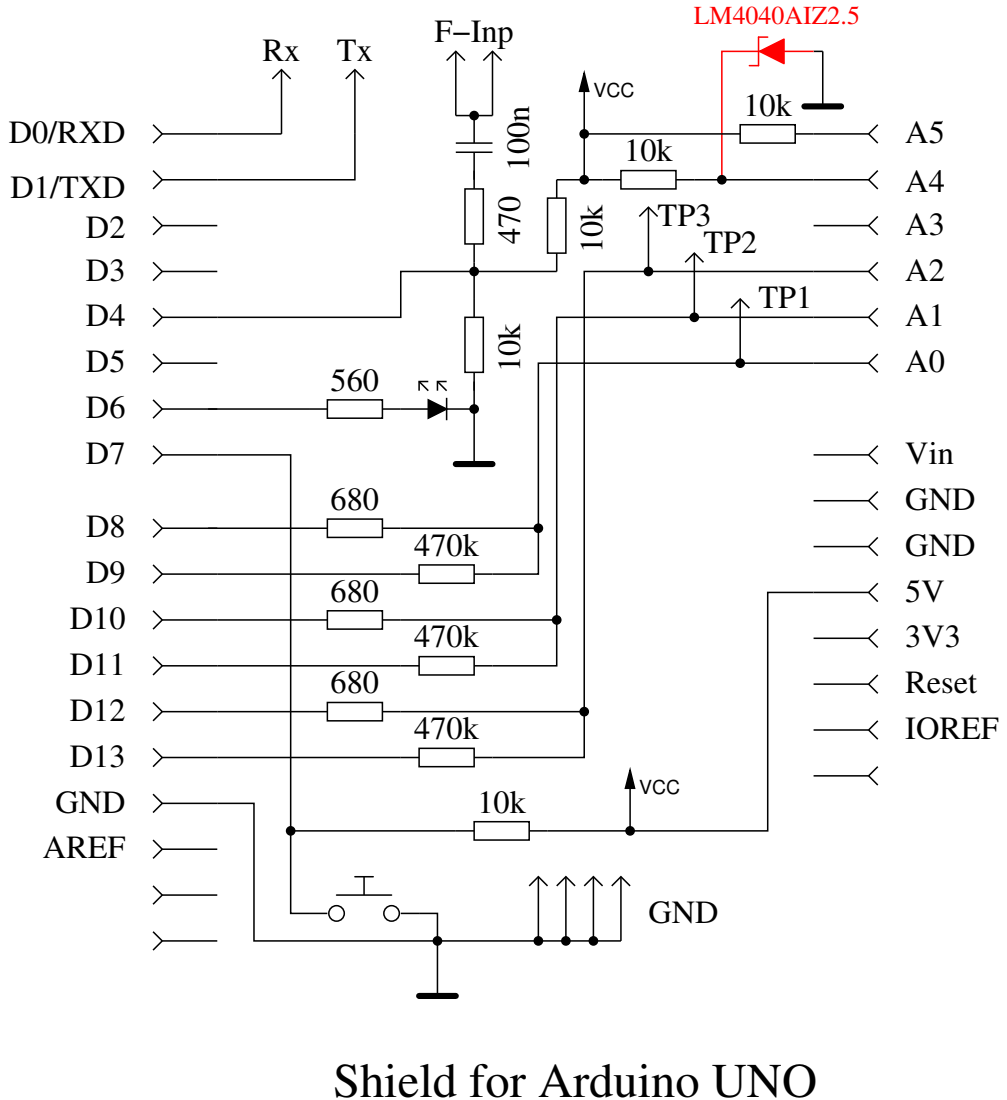
[picture p229: page 1]

Shield for Arduino UNO
