Mikrocontroller-net/transistortester/Hardware/strip_grid/TransistorTester_strip.pdf

### ATmega8/88/168/328

9V

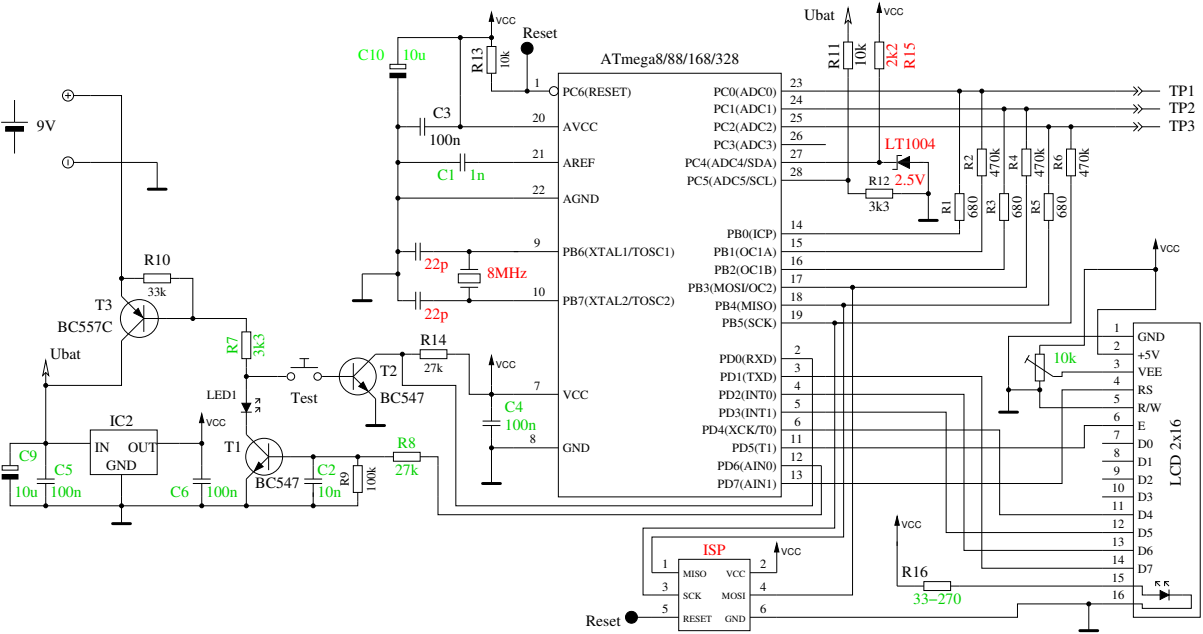
[picture p230: page 1]
