Mikrocontroller-net/transistortester/Hardware/Markus/LC-Meter-Option.pdf

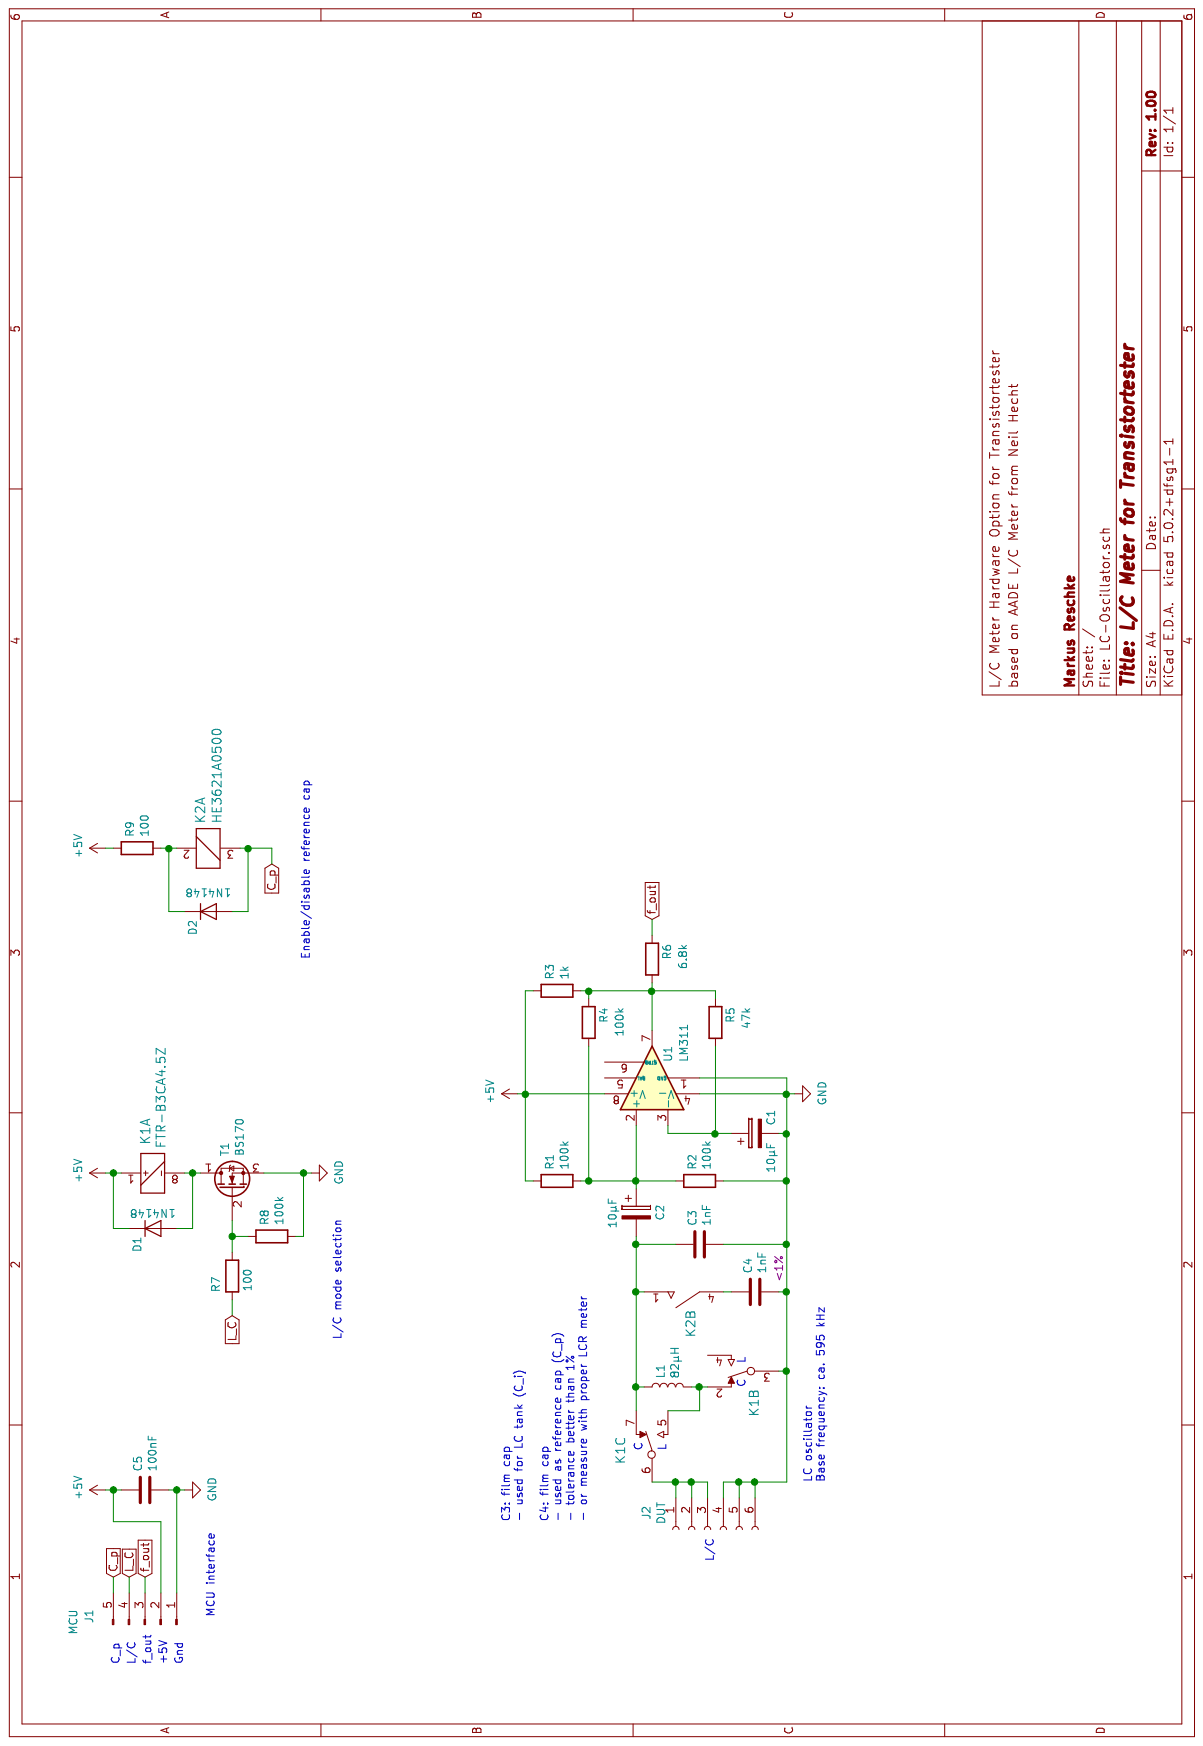
[picture p251: page 1]
