Mikrocontroller-net/transistortester/Hardware/Max/fritzing_sketch2_etch_copper_bottom.pdf

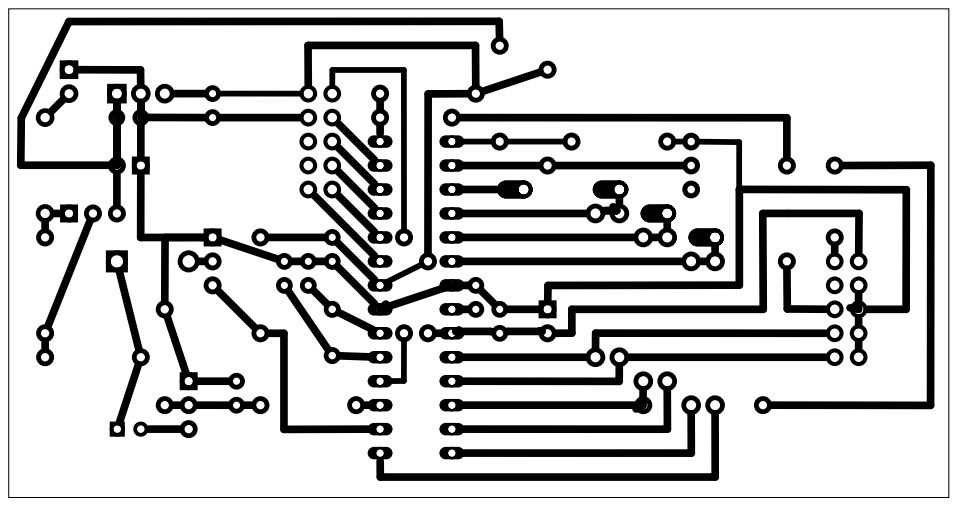
[picture p252: page 1]
