Mikrocontroller-net/transistortester/Hardware/strip_grid/TTester_strip.pdf

3.3k 3.3k

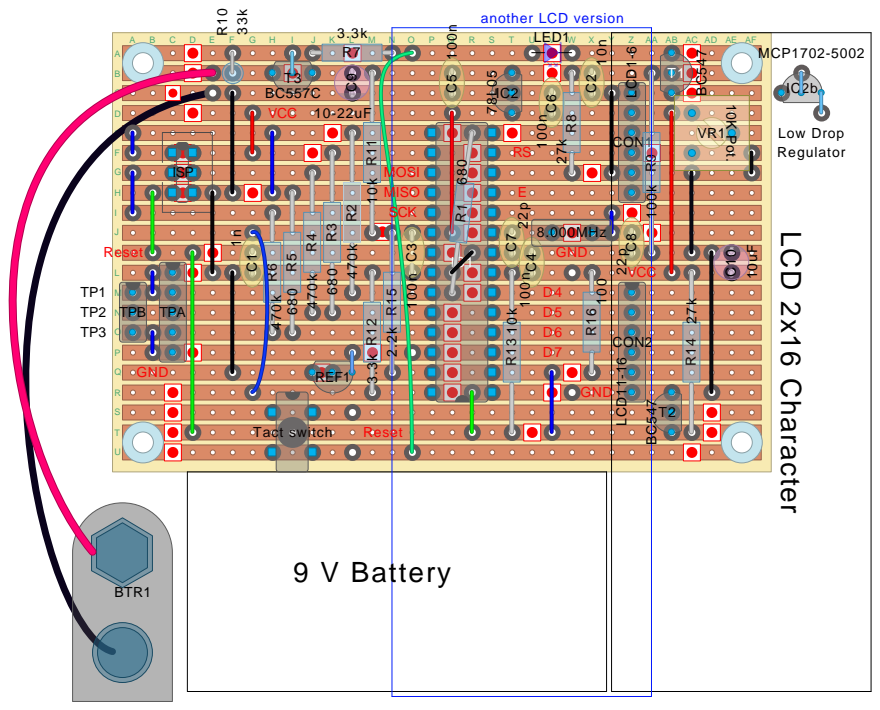
[picture p253: page 1]
