Mikrocontroller-net/transistortester/(list of files, drawings)

Other design files:
Hardware/Max/fritzing_sketch2.fzz
