Mikrocontroller-net/transistortester/Software/trunk/autoconf.h

#if ((LCD_ST_TYPE == 7565) || (LCD_ST_TYPE == 1306) || (LCD_ST_TYPE == 7108) || (LCD_ST_TYPE == 7920) || (LCD_ST_TYPE == 7735) || (LCD_ST_TYPE == 9163) || (LCD_ST_TYPE == 9341) || (LCD_ST_TYPE == 1327))
 #if ((SCREEN_HEIGHT > 128) && (SCREEN_WIDTH > 255))
  #define ONE_B 16
 #else
  #define ONE_B 8
 #endif
 #define WITH_GRAPHICS 1
 #undef PAGES_PER_LINE
 #define PAGES_PER_LINE ((FONT_HEIGHT + 7) / 8)
 #undef LCD_LINES
 #define LCD_LINES ((SCREEN_HEIGHT/ONE_B) / PAGES_PER_LINE)
 #undef LCD_LINE_LENGTH
 #define LCD_LINE_LENGTH (SCREEN_WIDTH / (ONE_B/8) / FONT_H_SPACE )
 #define TEXT_RIGHT_TO_ICON ((ICON_WIDTH + 16 + 5 + 7) / FONT_H_SPACE)
#elif (LCD_ST_TYPE == 8812)
 #define ONE_B 8
 #define WITH_GRAPHICS 1
 #undef PAGES_PER_LINE
 #define PAGES_PER_LINE ((FONT_HEIGHT + 7) / 8)
 #undef LCD_LINES
 #define LCD_LINES ((SCREEN_HEIGHT/8) / PAGES_PER_LINE)
 #undef LCD_LINE_LENGTH
 #define LCD_LINE_LENGTH (SCREEN_WIDTH / FONT_H_SPACE)
 #define TEXT_RIGHT_TO_ICON ((ICON_WIDTH + 16 + 5 + 7) / FONT_H_SPACE)
#elif (LCD_ST_TYPE == 8814)
 #define ONE_B 8
 #define WITH_GRAPHICS 1
 #undef PAGES_PER_LINE
 #define PAGES_PER_LINE ((FONT_HEIGHT + 7) / 8)
 #undef LCD_LINES
 #define LCD_LINES ((SCREEN_HEIGHT/8) / PAGES_PER_LINE)
 #undef LCD_LINE_LENGTH
 #define LCD_LINE_LENGTH (SCREEN_WIDTH / FONT_H_SPACE)
 #define TEXT_RIGHT_TO_ICON ((ICON_WIDTH + 16 + 5 + 7) / FONT_H_SPACE)
#else
 #define TEXT_RIGHT_TO_ICON 0
  #define FONT_HEIGHT 8
#endif
 #define LCD_ST7565_H_OFFSET 0
 #define LCD_ST7565_Y_START  0
#if LCD_ST7565_Y_START >= SCREEN_HEIGHT
 #warning LCD_ST7565_Y_START is set higher than SCREEN_HEIGHT!
#endif
#ifndef LCD_LINE_LENGTH
 #define LCD_LINE_LENGTH 16
#endif
#if (defined(WITH_GRAPHICS) && (((SCREEN_WIDTH-(TEXT_RIGHT_TO_ICON*FONT_H_SPACE))/FONT_H_SPACE) < 9))
 #define LOW_H_SPACE 1
#else
 #define LOW_H_SPACE 0
#endif
#if (LCD_ST_TYPE != 7920)
#define lcd_refresh()
#endif
#if (LCD_LINES < 2)
 #warning LCD_LINES is not correctly set!
 #if (SCREEN_HEIGHT < 32)
  #warning SCREEN_HEIGHT is not correctly set!
 #endif
 #if (FONT_HEIGHT < 8)
  #warning FONT_HEIGHT is not correctly set!
 #endif
#endif
#if (LCD_LINES < 7) && defined(WITH_6_SELECTION_MENU)
 #warning Display has not sufficient count of lines for WITH_6_SELECTION_MENU !
 #undef WITH_6_SELECTION_MENU
#endif
#if (PROCESSOR_TYP == 8) || (PROCESSOR_TYP == 168) || (PROCESSOR_TYP == 328)
 #if FLASHEND > 0x1fff
  #ifdef TQFP_ADC6
    #undef TPext
    #define TPext ((1<<MUX2) | (1<<MUX1))
    #ifdef TQFP_ADC7
      #define TPex2 ((1<<MUX2) | (1<<MUX1) | (1<<MUX0))
    #endif
  #else
    #ifdef TQFP_ADC7
      #undef TPext
      #define TPext ((1<<MUX2) | (1<<MUX1) | (1<<MUX0))
    #else
     #if (WITH_UART != 0) && (WITH_VEXT != 0)
      #warning "WITH_VEXT deselected, PC3 is used for UART"
      #undef WITH_VEXT
     #endif
    #endif
  #endif
 #else
  #ifndef BAT_CHECK
    #ifdef TQFP_ADC6
      #undef TPext
      #define TPext ((1<<MUX2) | (1<<MUX1))
    #endif
    #ifdef TQFP_ADC7
      #undef TPext
      #define TPext ((1<<MUX2) | (1<<MUX1) | (1<<MUX0))
    #endif
    #if (WITH_UART == 1) && (TQFP_ADC6 == 0) && (TQFP_ADC7 == 0) && (WITH_VEXT != 0)
      #warning "WITH_VEXT deselected, PC3 is used for UART"
      #undef WITH_VEXT
    #endif
  #endif
 #endif
#endif
#if BAT_NUMERATOR < BAT_DENOMINATOR
 #warning "Wrong BAT_NUMERATOR / BAT_DENOMINATOR setting!"
#endif
#if EXT_NUMERATOR < EXT_DENOMINATOR
 #warning "Wrong EXT_NUMERATOR / EXT_DENOMINATOR setting!"
#endif
  #define R_L_VAL 6800          // standard value 680 Ohm, multiplied by 10 for 0.1 Ohm resolution
  #define R_H_VAL 47000         // standard value 470000 Ohm, multiplied by 10, divided by 100
#if R_ANZ_MESS < ANZ_MESS
 #undef R_ANZ_MESS
 #define R_ANZ_MESS ANZ_MESS
#endif
#if U_SCALE < 1
 #undef U_SCALE
 #define U_SCALE 1
#endif
#if U_SCALE > 4
 #undef U_SCALE
 #define U_SCALE 4
#endif
 #define REF_L_KORR 50
#ifdef USE_EEPROM
 #define MEM_TEXT EEMEM
 #define lcd_MEM_string(a)  lcd_fix_string(a)
 #if E2END > 0X1FF
  #define MEM2_TEXT EEMEM
  #define MEM2_read_byte(a)  eeprom_read_byte(a)
  #define MEM2_read_word(a)  eeprom_read_word(a)
  #define lcd_MEM2_string(a)  lcd_fix_string(a)
  #define use_lcd_pgm
 #else
  #define MEM2_TEXT PROGMEM
  #define MEM2_read_byte(a)  pgm_read_byte(a)
  #define MEM2_read_word(a)  pgm_read_word(a)
  #define lcd_MEM2_string(a)  lcd_pgm_string(a)
  #define use_lcd_pgm
 #endif
 #define MEM_EEPROM
 #define MEM_read_word(a)  eeprom_read_word(a)
 #define MEM_read_byte(a)  eeprom_read_byte(a)
#else
 #define MEM_TEXT PROGMEM
 #define lcd_MEM_string(a)  lcd_pgm_string(a)
 #define MEM2_TEXT PROGMEM
 #define MEM_read_word(a)  pgm_read_word(a)
 #define MEM_read_byte(a)  pgm_read_byte(a)
 #define MEM2_read_byte(a)  pgm_read_byte(a)
 #define MEM2_read_word(a)  pgm_read_word(a)
 #define lcd_MEM2_string(a)  lcd_pgm_string(a)
 #define use_lcd_pgm
#endif
#if FLASHEND > 0X1FFF
 #define ACALL call
#else
 #define ACALL rcall
#endif
#if PROCESSOR_TYP == 168
  #define MCU_STATUS_REG MCUCR
  #define ADC_COMP_CONTROL ADCSRB
  #define TI1_INT_FLAGS TIFR1
  #define DEFAULT_BAND_GAP 1070
 #if R_H_VAL == 10000
  #define DEFAULT_RH_FAKT 4022      // mega168 1101 mV, 100.0 kOhm
 #else
  #define DEFAULT_RH_FAKT  856      // mega168 1101 mV, 470.0 kOhm
 #endif
  #define LONG_HFE
  #define PIN_RM 196
  #define PIN_RP 221
  #define CC0 36
  #define COMP_SLEW1 4000
  #define COMP_SLEW2 220
  #define C_NULL CC0+CABLE_CAP+(COMP_SLEW1 / (CC0 + CABLE_CAP + COMP_SLEW2))
  #define MUX_INT_REF 0x0e
#elif PROCESSOR_TYP == 328
  #define MCU_STATUS_REG MCUCR
  #define ADC_COMP_CONTROL ADCSRB
  #define TI1_INT_FLAGS TIFR1
  #define DEFAULT_BAND_GAP 1070
 #if R_H_VAL == 10000
  #define DEFAULT_RH_FAKT 4022      // mega328 1101 mV, 100.0 kOhm
 #else
  #define DEFAULT_RH_FAKT  856      // mega328 1101 mV, 470.0 kOhm
 #endif
  #define LONG_HFE
  #define PIN_RM 200
  #define PIN_RP 220
  #define CC0 36
  #define COMP_SLEW1 4000
  #define COMP_SLEW2 180
  #define C_NULL CC0+CABLE_CAP+(COMP_SLEW1 / (CC0 + CABLE_CAP + COMP_SLEW2))
  #define MUX_INT_REF 0x0e
#elif PROCESSOR_TYP == 644
  #define WITH_ROTARY_CHECK
  #define WITH_UJT
  #define WITH_PUT
  #define MCU_STATUS_REG MCUCR
  #define ADC_COMP_CONTROL ADCSRB
  #define TI1_INT_FLAGS TIFR1
  #define DEFAULT_BAND_GAP 1070
 #if R_H_VAL == 10000
  #define DEFAULT_RH_FAKT 4022      // mega1280 1101 mV, 100.0 kOhm
 #else
  #define DEFAULT_RH_FAKT  856      // mega1280 1101 mV, 470.0 kOhm
 #endif
  #define LONG_HFE
  #define PIN_RM 200
  #define PIN_RP 220
  #define CC0 36
  #define COMP_SLEW1 4000
  #define COMP_SLEW2 180
  #define C_NULL CC0+CABLE_CAP+(COMP_SLEW1 / (CC0 + CABLE_CAP + COMP_SLEW2))
  #define MUX_INT_REF 0x1e
#elif PROCESSOR_TYP == 1280
 #ifndef WITH_ROTARY_CHECK
  #define WITH_ROTARY_CHECK
 #endif
  #define MCU_STATUS_REG MCUCR
  #define ADC_COMP_CONTROL ADCSRB
  #define TI1_INT_FLAGS TIFR1
  #define DEFAULT_BAND_GAP 1070
 #if R_H_VAL == 10000
  #define DEFAULT_RH_FAKT 4022      // mega1280 1101 mV, 100.0 kOhm
 #else
  #define DEFAULT_RH_FAKT  856      // mega1280 1101 mV, 470.0 kOhm
 #endif
  #define LONG_HFE
  #define PIN_RM 200
  #define PIN_RP 220
  #define CC0 36
  #define COMP_SLEW1 4000
  #define COMP_SLEW2 180
  #define C_NULL CC0+CABLE_CAP+(COMP_SLEW1 / (CC0 + CABLE_CAP + COMP_SLEW2))
  #define MUX_INT_REF 0x1e
#else
  #define MCU_STATUS_REG MCUCSR
  #define ADC_COMP_CONTROL SFIOR
  #define TI1_INT_FLAGS TIFR
  #define DEFAULT_BAND_GAP 1298		//mega8 1298 mV
 #if R_H_VAL == 10000
  #define DEFAULT_RH_FAKT 3328      // mega8 1298 mV, 100.0 kOhm
 #else
  #define DEFAULT_RH_FAKT  740      // mega8 1250 mV, 470.0 kOhm
 #endif
  #define LONG_HFE
  #define PIN_RM 196
  #define PIN_RP 240
  #define CC0 27
  #define COMP_SLEW1 0
  #define COMP_SLEW2 33
  #define C_NULL CC0+CABLE_CAP+(COMP_SLEW1 / (CC0 + CABLE_CAP + COMP_SLEW2))
  #define MUX_INT_REF 0x0e
  #define INHIBIT_SLEEP_MODE
  #warning "SLEEP_MODE not possible with mega8"
#endif
 #define REF_R_KORR 0
 #define REF_C_KORR 0
#ifdef POWER_OFF
 #if (POWER_OFF+0) > 2
  #define OFF_WAIT_TIME SHORT_WAIT_TIME
 #else
  #define OFF_WAIT_TIME (LONG_WAIT_TIME - 1)
 #endif
#else
 #define OFF_WAIT_TIME  (LONG_WAIT_TIME - 1)
#endif
#define F_ADC 200000
#if F_CPU/F_ADC <= 2
 #define TICS_PER_ADC_CLOCK 2
 #define AUTO_CLOCK_DIV ((0<<ADPS2) | (0<<ADPS1) | (1<<ADPS0))
#elif F_CPU/F_ADC <= 4
 #define TICS_PER_ADC_CLOCK 4
 #define AUTO_CLOCK_DIV ((0<<ADPS2) | (1<<ADPS1) | (0<<ADPS0))
#elif F_CPU/F_ADC <= 8
 #define TICS_PER_ADC_CLOCK 8
 #define AUTO_CLOCK_DIV ((0<<ADPS2) | (1<<ADPS1) | (1<<ADPS0))
#elif F_CPU/F_ADC <= 16
 #define TICS_PER_ADC_CLOCK 16
 #define AUTO_CLOCK_DIV ((1<<ADPS2) | (0<<ADPS1) | (0<<ADPS0))
#elif F_CPU/F_ADC <= 32
 #define TICS_PER_ADC_CLOCK 32
 #define AUTO_CLOCK_DIV ((1<<ADPS2) | (0<<ADPS1) | (1<<ADPS0))
#elif F_CPU/F_ADC <= 64
 #define TICS_PER_ADC_CLOCK 64
 #define AUTO_CLOCK_DIV ((1<<ADPS2) | (1<<ADPS1) | (0<<ADPS0))
#else
 #define TICS_PER_ADC_CLOCK 128
 #define AUTO_CLOCK_DIV ((1<<ADPS2) | (1<<ADPS1) | (1<<ADPS0))
#endif
#ifndef PIN_RP
  #define PIN_RP  220           //estimated internal resistance PORT to VCC
#endif
#ifndef PIN_RM
  #define PIN_RM  190           //estimated internal resistance PORT to GND
#endif
#ifdef INHIBIT_SLEEP_MODE
 #define wait_about5ms() wait5ms()
 #define wait_about10ms() wait10ms()
 #define wait_about20ms() wait20ms()
 #define wait_about30ms() wait30ms()
 #define wait_about50ms() wait50ms()
 #define wait_about100ms() wait100ms()
 #define wait_about200ms() wait200ms()
 #define wait_about300ms() wait300ms()
 #define wait_about400ms() wait400ms()
 #define wait_about500ms() wait500ms()
 #define wait_about1s() wait1s()
 #define wait_about2s() wait2s()
 #define wait_about3s() wait3s()
 #define wait_about4s() wait4s()
 #define wait_about5s() wait5s()
#else
 #define wait_about5ms() sleep_5ms(1)
 #define wait_about10ms() sleep_10ms()
 #define wait_about20ms() sleep_5ms(4)
 #define wait_about30ms() sleep_5ms(6)
 #define wait_about50ms() sleep_5ms(10)
 #define wait_about100ms() sleep_5ms(20)
 #define wait_about200ms() sleep_5ms(40)
 #define wait_about300ms() sleep_5ms(60)
 #define wait_about400ms() sleep_5ms(80)
 #define wait_about500ms() sleep_5ms(100)
 #define wait_about1s() sleep_5ms(200)
 #define wait_about2s() sleep_5ms(202)
 #define wait_about3s() sleep_5ms(203)
 #define wait_about4s() sleep_5ms(204)
 #define wait_about5s() sleep_5ms(205)
#endif
#ifndef WITH_SELFTEST
 #ifdef AUTO_CAL
  #undef AUTO_CAL
  #warning "No AUTO_CAL without WITH_SELFTEST!"
 #endif
#endif
#undef AUTO_RH
#ifdef WITH_AUTO_REF
 #define AUTO_RH
#else
 #ifdef AUTO_CAL
  #define AUTO_RH
 #endif
#endif
#ifdef AUTO_CAL
  #define RR680PL resis680pl
  #define RR680MI resis680mi
  #define RRpinPL pin_rpl
  #define RRpinMI pin_rmi
#else
  #define RR680PL (R_L_VAL + PIN_RP)
  #define RR680MI (R_L_VAL + PIN_RM)
  #define RRpinPL (PIN_RP)
  #define RRpinMI (PIN_RM)
#endif
 #define ESR_ZERO 20
 #define RESTART_DELAY_TICS 16384
#if EBC_STYLE == 123
 #undef EBC_STYLE
#endif
#define LCD_CHAR_DIODE1  1      //Diode-Icon; will be generated as custom character
#define LCD_CHAR_DIODE2  2      //Diode-Icon;  will be generated as custom character
#define LCD_CHAR_CAP 3          //Capacitor-Icon;  will be generated as custom character
#define LCD_CHAR_RESIS1 4       // Resistor left part will be generated as custom character
#define LCD_CHAR_RESIS2 5       // Resistor right part will be generated as custom character
#ifdef LCD_CYRILLIC
        #define LCD_CHAR_OMEGA  7       // Omega-character cyrillic LCD
        #define LCD_CHAR_U  6           // mu-character cyrillic LCD
#else
        #define LCD_CHAR_OMEGA  244     // Omega-character standard LCD
        #define LCD_CHAR_U  228         // mu-character standard LCD
#endif
#ifdef LCD_DOGM
	#undef LCD_CHAR_OMEGA
	#define LCD_CHAR_OMEGA 0x1e	//Omega-character for DOGM module
        #undef LCD_CHAR_U
        #define LCD_CHAR_U  6           //mu-character for DOGM module loadable
#endif
#define LCD_CHAR_DEGREE 0xdf            // Character for degree
#define LCD_CHAR_INSEP 0xff		// used as space character without separating text
#define LCD_NO_SPACE 0xfe               // used to separate text without space
#define LCD_CHAR_LINE1 '-'		// usually the minus sign is used for line symbol
#define LCD_CHAR_INDUCTOR1 'w'		// use ww for inductor symbol
#define LCD_CHAR_INDUCTOR2 'w'		// use ww for inductor symbol
#if (defined(WITH_GRAPHICS) || defined(LCD_USE_OWN_FONT))
        #undef LCD_CHAR_DEGREE
        #undef LCD_CHAR_OMEGA
        #undef LCD_CHAR_U
        #undef LCD_CHAR_LINE1
        #define LCD_CHAR_LINE1  6	// line is specified as long -
        #undef LCD_CHAR_INDUCTOR1
        #define LCD_CHAR_INDUCTOR1  7		//begin of coil
        #undef LCD_CHAR_INDUCTOR2
        #define LCD_CHAR_INDUCTOR2  8		//end of coil
 #if (defined WITH_GRAPHICS)
	#define LCD_CHAR_DEGREE 0x1f
	#define LCD_CHAR_U	0x1e		// mu character for graphic display
	#define LCD_CHAR_OMEGA	0x1d		// Omega character for graphic display
	#define LCD_CHAR_BETA	0x1c		// Beta character for graphic display
 #else
        #define LCD_CHAR_DEGREE 0xf8	// Character for degree
        #define LCD_CHAR_OMEGA  13       //Omega-character
        #define LCD_CHAR_U  14		//\B5-character
	#define LCD_CHAR_BETA 12
 #endif
#endif
#if FLASHEND > 0x3fff
 #define LCD_CHAR_RESIS3 0
#else
 #define LCD_CHAR_RESIS3 'R'
#endif
#if FLASHEND > 0x1fff
 #define SEARCH_PARASITIC
#endif
 #define WITH_THYRISTOR_GATE_V
#if FLASHEND > 0x1fff
 #define SHOW_R_DS
 #if defined(NO_COMMON_EMITTER_HFE) && !defined(NO_TEST_T1_T7) && (FLASHEND < 0x3fff)
  #warning  Uf parameter of VAKDiode and ICE can not be shown with full selftest
 #else
  #define SHOW_VAKDIODE
  #define SHOW_ICE
 #endif
#endif
#ifndef NO_COMMON_COLLECTOR_HFE
 #define COMMON_COLLECTOR
#endif
#if FLASHEND > 0x1fff
 #ifndef NO_COMMON_EMITTER_HFE
   #define COMMON_EMITTER
 #endif
#endif
#ifdef COMMON_EMITTER
 #ifdef COMMON_COLLECTOR
  #define BOTH_HFE
  #if FLASHEND > 0x3fff
    #define EXTENDED_TESTS
  #endif
 #else
    #define EXTENDED_TESTS
 #endif
#else
 #define EXTENDED_TESTS
#endif
#ifdef COMMON_COLLECTOR
 #ifndef COMMON_EMITTER
    #define EXTENDED_TESTS
 #endif
#else
 #ifndef COMMON_EMITTER
    #warning "No hFE measurement type selected, common collector circuit choosed!"
    #define COMMON_COLLECTOR
    #define EXTENDED_TESTS
 #endif
#endif
#ifdef NO_TEST_T1_T7
 #undef EXTENDED_TESTS
#endif
#ifdef EXTENDED_TESTS
 #if FLASHEND <= 0x3fff
  #ifdef WITH_UART
   #warning "Serial Output is deselected to save memory!"
   #undef WITH_UART
  #endif
  #ifdef BOTH_HFE
   #undef SEARCH_PARASITIC
   #warning "Search of parasitic transistor not possible. NPNp or PNPn result depends on the selected pin sequence!"
  #endif
  #ifdef SHOW_ICE
   #ifdef BOTH_HFE
    #undef SHOW_ICE
    #warning "Display of ICE is disabled to save memory!"
   #endif
  #endif
 #endif
#endif
#ifdef WITH_SELFTEST
 #define WAIT_LINE2_CLEAR
#endif
#ifdef SHOW_ICE
 #define WAIT_LINE2_CLEAR
#endif
#ifdef WAIT_LINE2_CLEAR
 #define LCD_CLEAR
#endif
#ifdef WITH_VEXT
 #define LCD_CLEAR
#endif
#ifdef DEBUG_OUT
 #define LCD_CLEAR
#endif
#if ((F_CPU/100) / 32) < 256
 #define CNTR2_PRESCALER (0<<CS22) | (1<<CS21) | (1<<CS20)
 #define TICS_PER_T2_COUNT 32
#elif ((F_CPU/100) / 64) < 256
 #define CNTR2_PRESCALER (1<<CS22) | (0<<CS21) | (0<<CS20)
 #define TICS_PER_T2_COUNT 64
#elif ((F_CPU/100) / 128) < 256
 #define CNTR2_PRESCALER (1<<CS22) | (0<<CS21) | (1<<CS20)
 #define TICS_PER_T2_COUNT 128
#elif ((F_CPU/100) / 256) < 256
 #define CNTR2_PRESCALER (1<<CS22) | (1<<CS21) | (0<<CS20)
 #define TICS_PER_T2_COUNT 256
#else
 #define CNTR2_PRESCALER (1<<CS22) | (1<<CS21) | (1<<CS20)
 #define TICS_PER_T2_COUNT 1024
#endif
#if FLASHEND <= 0x3fff
 #ifdef WITH_MENU
  #undef WITH_MENU
  #warning "no WITH_MENU possible with ATmega8 or ATmega168"
 #endif
#endif
#ifdef __ASSEMBLER__
     .macro  AOUT adr, reg
     .if  _SFR_IO_REG_P(\adr)
        out     _SFR_IO_ADDR(\adr), \reg
     .else
        sts     \adr, \reg
     .endif
     .endm
     .macro  AIN reg, adr
     .if  _SFR_IO_REG_P(\adr)
        in     \reg, _SFR_IO_ADDR(\adr)
     .else
        lds     \reg, \adr
     .endif
     .endm
     .macro LDIZ adr
	ldi	ZL, lo8(\adr)
	ldi	ZH, hi8(\adr)
     .endm
#endif
 #define TP_OFFSET 0
#if  !defined(LCD_INTERFACE_MODE)  || (LCD_INTERFACE_MODE == MODE_PARALLEL) || (LCD_INTERFACE_MODE == MODE_I2C) || (LCD_INTERFACE_MODE == MODE_I2C_CHAR)
 #define MODE_8BIT 0x00
#else
 #define MODE_8BIT 0x10
#endif
#if defined(WITH_GRAPHICS) && !defined(NO_ICONS_DEMO)
  #undef SHOW_ICONS
  #define SHOW_ICONS
#endif
#ifdef PWM_SERVO
  #define SERVO_MIN 40
  #define SERVO_MAX 111
  #define SERVO_PERIOD 20000UL
 #define SERVO_DIV 1
 #define SERVO_START ((0<<CS12) | (0<<CS11) | (1<<CS10))
 #if ((SERVO_PERIOD*MHZ_CPU)  > 0xffff)
  #undef SERVO_DIV
  #define SERVO_DIV 8
  #undef SERVO_START
  #define SERVO_START ((0<<CS12) | (1<<CS11) | (0<<CS10))
  #if (((SERVO_PERIOD * MHZ_CPU) / SERVO_DIV) > 0xffff)
   #undef SERVO_DIV
   #define SERVO_DIV 64
   #undef SERVO_START
   #define SERVO_START ((0<<CS12) | (1<<CS11) | (1<<CS10))
  #endif
 #endif
 #if SERVO_MAX > 251
  #warning  The maximum pulse width SERVO_MAX must set below 25.2% !
  #undef SERVO_MAX
  #define SERVO_MAX 251
 #endif
 #if SERVO_MIN >= SERVO_MAX
  #warning  The minimum pulse width SERVO_MIN must set below SERVO_MAX !
  #undef SERVO_MIN
  #define SERVO_MIN (SERVO_MAX/2)
 #endif
 #define PWM_MAX_COUNT ((SERVO_PERIOD * MHZ_CPU) / SERVO_DIV)
 #if PWM_MAX_COUNT < 0x3ff
  #warning PWM_MAX_COUNT
 #endif
#else
 #ifndef SERVO_MIN
  #define SERVO_MIN 0
 #endif
 #ifndef SERVO_MAX
  #define SERVO_MAX 100
 #endif
 #define PWM_MAX_COUNT 0x3ff
#endif
#if (TP1 < TP2) && (TP1 < TP3)
 #define TP_MIN TP1
#endif
#if (TP2 < TP1) && (TP2 < TP3)
 #define TP_MIN TP2
#endif
#if (TP3 < TP1) && (TP3 < TP2)
 #define TP_MIN TP3
#endif
#ifndef WITH_UART
 #define uart_newline()	// ignored
#endif
#if defined(LCD_SPI_OPEN_COL) && defined(WITH_ROTARY_SWITCH)
  #pragma message "Option WITH_ROTARY_SWITCH can not be used together with option LCD_SPI_OPEN_COL, if the ROTARY switch signals use the same port signals as the LCD."
#endif
#define USE_ESR 1
#define USE_RESIS 1
#define USE_CAP13 1
#ifdef NO_FREQ_COUNTER
 #define USE_FREQ 0
 #define USE_HFREQ 0
 #define USE_H_CRYSTAL 0
 #define USE_L_CRYSTAL 0
 #define NO_FREQUENCY_SWITCH 0
#else
 #if (PROCESSOR_TYP == 644) && (NO_FREQUENCY_SWITCH != 1)
  #define USE_FREQ 1
  #define USE_HFREQ 1
  #define USE_H_CRYSTAL 1
  #define USE_L_CRYSTAL 1
  #define WITH_FREQUENCY_SWITCH 1
 #else
  #define USE_FREQ 1
  #define USE_HFREQ 0
  #define USE_H_CRYSTAL 0
  #define USE_L_CRYSTAL 0
  #define WITH_FREQUENCY_SWITCH 0
 #endif
#endif
#if (defined WITH_FREQUENCY_DIVIDER) && (USE_FREQ == 1)
 #define USE_FSCALER 1
#else
 #define USE_FSCALER 0
#endif
#define USE_FGEN 1
#define USE_PWM 1
#define USE_BIG_CAP_CORR 1
#ifdef WITH_ROTARY_CHECK
 #define USE_ROTARY 1
#else
 #define USE_ROTARY 0
#endif
#ifdef WITH_VEXT
 #define USE_VEXT 1
#else
 #define USE_VEXT 0
#endif
#ifdef WITH_SELFTEST
 #define USE_SELFTEST 1
#else
 #define USE_SELFTEST 0
#endif
#if ((LCD_ST_TYPE == 7565) || (LCD_ST_TYPE == 1306) || defined(LCD_DOGM))
 #define USE_CONTRAST 1
#else
 #define USE_CONTRAST 0
#endif
#ifdef LCD_CHANGE_COLOR
 #define USE_SELECT_FG 1
 #define USE_SELECT_BG 1
#else
 #define USE_SELECT_FG 0
 #define USE_SELECT_BG 0
#endif
#define USE_SHOW 1
#ifdef POWER_OFF
 #define USE_OFF 1
#else
 #define USE_OFF 0
#endif
#define MODE_TRANS 0
 #include "function_sequence1.h"
