Mikrocontroller-net/transistortester/(commit log)

2012-06-08 Neue Doku und Software
2012-06-09 Version 0.97k der Doku hinzugefügt
2012-06-09 Version 0.97k der Software hinzugefügt
2012-06-10 Anpassungsmöglichkeit für leeren Kondensator in der Makefile
2012-06-28 Verbesserung Widerstandsmessung und ANZ_MESS Fehler
2012-07-09 Overflow Problem bei Kondensatormessung
    [ReadCapacity.c, config.h, main.c]
2012-07-17 Optimierung der Kondensatormessung
2012-07-26 Untersuchung und Anpassung mega168
2012-07-28 automatische Entfernung von überflüssigen Code, wenn keine POWER_OFF=5 Option
2012-08-03 Vergleich der Kondensatormessungen, Multimeter,LCR, TTester hinzugefügt
2012-08-06 Autokalibration Kondensator-Nullwert und Pin-Ausgangswiderstände
2012-08-07 kleine Korrektur und Doku ergänzt
2012-08-08 Neue Halbleitermessung in der Doku
2012-08-09 PicoPower Version in Makefile und config.h berücksichtigt
2012-08-10 Ausgabeformat Schwellspannung FET in V
2012-08-12 Eintragefehler 56nF und ATmega8 Anpassung
2012-08-13 Kondensatormessungen mit ATmega328 und ATmega328P ergänzt
2012-08-14 capacitor measurements of ATmega328 and ATmega328P added
2012-08-14 graphische Aufbereitung der Selbsttest Ergebnisse
2012-08-15 Doku fuer ATmega168 und ATmega328 AUTO_CAL ueberarbeitet
2012-09-07 Erweiterung der AUTO_CAL Funktion fuer AUTOSCALE_ADC
2012-09-09 Fehlerbeseitigung bei Konfiguration des EEprom Zugriffs
2012-09-09 PD7 Pin Nummer berichtigt.
2012-09-11 Selbsttest und AUTO_CAL getrennt
2012-09-22 Anpassung und Erweiterung der Induktionsmessung
2012-09-25 Beseitigung des Fehlers bei grossen Widertstaenden
2012-10-05 Beschreibung und Aenderung der ESR-Messung
2012-10-19 Induktivitätsmessung nur bei Widerständen kleiner 2100 Ohm
2012-11-02 entfernen der mega8_auto version
2012-11-03 Ergaenzung der Schaltplans im Hardware/strip_grid Pfad
2012-11-04 Umlaute im tex Quelltext fuer die Dokumentation
2012-11-18 Anpassung der Makefile an WinAVR
2012-11-25 NL Sprache und Dank im Vorwort
2012-11-26 entfernen der mega48 Unterstuetzung in der Makefile
2012-11-26 Anpassung GetESR an Suche der maximalen Kapazitaet
2012-11-29 Ueberarbeitung der Doku
2012-12-02 Version 1.04k, Bugfix , ueberarbeitete Doku
    [ReadCapacity.c]
2012-12-07 Test anderer Methode der MOS Vth Spannungsmessung
2013-01-25 Pin layout with 123= style for thyristor and mega8
2013-01-31 Messmoeglichkeit externer 50V Spannung ergaenzt
2013-02-06 Problem ohne Abschaltelektronik beseitigt
    [main.c]
2013-02-09 Wahlmoeglichkeit fuer Pin-Anzeige 321=...
2013-02-18 Verbesserung der Induktivitäts-Messung
2013-02-22 volatile Zusatz fuer Interrupt Variablen ergaenzt
2013-02-24 Darstellung einer Einzeldiode in Pin-Anordnung
2013-03-05 ESR Messung ab 0.45uF mit 500kHz ADC Clock
2013-03-08 Umstellung des BAT_POOR Pegels auf mV
2013-03-21 GetESR in Assembler, Ausgabe Spannungsverlust nach Ladepuls
2013-03-22 Version 1.06m und Hardware-Entwurf vom Markus R.
2013-04-08 Widerstandsmessung unter 10 Ohm mit ESR-Methode
2013-04-17 ReadADC in Assembler-Sprache
2013-04-19 Version 1.07k mit neuer ESR-Meßmethode und Vloss
2013-05-07 einstellbare BitClock avrdude, Reihenfolge Diodentest 470k/680 geändert
2013-05-15 Entladung von Dioden mit Zeitüberwachung
2013-06-21 Anpassung der Erkennung von Verarmungs FET wegen Reststrom
2013-07-13 Erweiterung des Diodentests
2013-07-13 Aktualisierung der Beschreibung Halbleitermessung
2013-09-25 Anpassung des 0.2V Offsets bis 3.25V BAT_POOR Pegel
2013-09-27 LiesMich.txt und ReadMe.txt im Quellcode-Verzeichnis ergaenzt.
2013-10-20 Begrenzung der Spannungsdifferenz der Diodenerkennung
2013-11-13 Ergaenzung der Programmfiles fuer DOGM LCD
2013-11-13 Ergaenzung der Programmfiles fuer DOGM LCD mit Streifenrasterlayout
2013-11-30 Overflow Problem der Kondensatormessung mit Sleep Mode beseitigt
    [ReadCapacity.c, config.h, main.c]
2013-12-03 in der Makefile make durch ersetzt
2013-12-18 Umbau Transistor Tests wegen NPNp und PNPn Erkennung
2013-12-19 Unterverzeichnisse fuer FiFi und Funkamateur Version
2013-12-28 Hinweis auf unkalibrierten Tester und Nullkapazitaet < 190pF
2014-01-02 Kollektor Reststrom Ausgabe und bessere Germanium Transistor Erkennung
2014-01-04 Doku/tags mit Unterverzeichnissen fuer Sprache und alte Versionen
2014-01-11 Erkennung von Schutzdioden bei D-MOSFET
2014-01-12 Anpassung fuer Zenerspannung bis 4.5V
2014-01-14 in einem Messzyklus wird Diode und Widerstand erkannt, BU508D
2014-01-14 Widerstandssymbol statt R als Hinweis bei Diodenmessung fuer mega328
2014-01-21 Erkennung Schutzdiode bei BDV65 , Assembler-Funktionen, ttinfo.pdf
2014-01-21 Korrektur mega168_3.3V und russische ttinfo.pdf
2014-01-21 Thyristorerkennung korrigiert, Fragezeichen in Zeile 1 = unKalibriert
    [CheckPins.c, GetRLmultip.c, ReadCapacity.c, Transistortester.h, lcd-routines.h, main.c, tt_function.h]
2014-01-22 fehlerhafter Zugriff auf EEprom-Tabelle in GetRLmultip korrigiert, mega8, mega168
    [config.h]
2014-01-22 Fehlerbeseitigung RvalOut.S und neue Funktionen i2lcd und u2lcd
2014-01-25 PinLayout und lcd-routines in Assembler, TRIAC Erkennung erweitert und dokomentiert
2014-01-26 geaenderte D-mode Erkennung und Aseembler wait_for_key_ms und get_log
2014-01-29 kleine Korrekturen und Ergänzungen
2014-01-29 Organisation der Abgleichwerte vereinfacht
2014-01-31 UART reset fuer Mega328 , Konfiguration Mega168 an flash angepasst
    [AutoCheck.c, ReadADC.c, Transistortester.h, autoconf.h, main.c]
2014-02-01 Initialisierung der Abgleichdaten, wenn USE_EEPROM nicht gesetzt ist, mega328
2014-02-04 Fehler mit GetRLmultip.S und Option USE_EEPROM beseitigt
2014-02-04 Vor Widerstandsmessung mit GetESR wird erst Induktivität geprüft
2014-02-07 Makro AOUT für Port-Zugriff, Russischer und Ukrainischer Hilfetext
2014-02-09 mega2560 auf arduino wird unterstuetzt
2014-02-10 doppelte Zuweisung von R_L_VAL und R_H_VAL entfernt
2014-02-10 Programm fuer Optionen WITH_SELFTEST und AUTO_CAL ueberarbeitet
2014-02-23 Extrafunktionen Frequenz und Spannungsmessung mit WITH_MENU
2014-02-27 ueberarbeite Frequenzmess und Frequenzgenerator Funktion
2014-02-28 einige Korrekturen und russische Dokumentation
2014-03-01 Frequenzmessung korrigiert mit 7 Dezimalstellen
    [DisplayValue.c, GetFrequency.c, Transistortester.h]
2014-03-02 Frequenzmessung verbessert und dokumentiert
2014-03-03 Optionen TQFP_ADC6 und TQFP_ADC7 fuer 32 Pin SMD Versionen
2014-03-06 10-Bit PWM Generator und verbesserte Frequenzmessung
2014-03-24 separate ESR-Messung, TRIAC Erkennung korrigiert, m324 Serie vorbereitet
    [CheckPins.c, GetESR.c, ReadADC.c, ReadBigCap.c, Transistortester.h, autoconf.h, config.h, function_menu.c]
2014-03-31 Nachtrag russische Uebersetzung der Doku
2014-04-08 Zeitsteuerung fuer Sonderfunktionen ueberarbeitet, POWER_OFF
2014-05-20 SPI interface signals
2014-05-23 Bugfix ST7565 display driver
2014-05-23 WITH_UART und WITH_MENU auch fuer ST7565 aktiv
2014-05-24 Korrekturen und Nachtrag in der russischen Doku Version
2014-05-29 Aufteilen der Makefile, setup.mk + finish.mk
2014-06-07 Flip of ST7565 display horizontal und vertikal getrennt
    [lcd-routines.c]
2014-06-14 Anpassung und Beschreibung der Drehinpulsgeber Bedienung
2014-06-18 Erweiterung der Impulsdrehgeber-Funktion
2014-06-19 Beschreibung der Impulsdrehgeberfunktion ergänzt
2014-06-30 Option WITH_VEXT in der Makefile fuer externe Spannung
2014-07-01 russische Uebersetzung der Dokumentation
2014-07-31 kein Warten bei 4-zeiligem Display bei Diode und Widerstand
2014-08-01 Pin setting for rotary switch and ST7565 controller
2014-08-03 Wartezeit vor der Ausgabe des Hilfetextes entfernt
2014-08-08 JFET Erkennung verbessert und Ergänzung Doku
2014-08-09 Aktualisierung der russischen Version der Dokumentation
2014-08-11 Adapter fuer Impulsdrehgeber und Frequenz-Eingang von Markus R.
2014-08-13 horizontal flip of ST7565 can be done with offset
    [lcd-routines.c]
2014-09-04 Aenderung der Pinbelegung Impulsdrehgeber. Anzeige Kalibrationsdaten
2014-09-05 keine Ausschalte-Funktion ohne Option POWER_OFF.
2014-09-06 Beschreibung ShowData und Kontrast ergaenzt.
2014-09-06 Vorzeichenfehler bei ShowData korrigiert.
    [ShowData.c]
2014-09-07 Korrektur der Kommentare in der Makefile
2014-09-08 Korrektur der Reihenfolge der R0 Werte in ShowData
2014-09-13 LCD-init fuer DOGM korrigiert
    [lcd-routines.c]
2014-10-05 Bei Start von AutoCheck wird PartFound auf unerkannt gesetzt
2014-10-10 Die gcc option -mcall-prologues wird verwendet
2014-10-24 corrected czech help text
    [Transistortester.h]
2014-11-02 Korrektur englische und russische Dokumentation
2014-11-27 Korrektur der englischen Infonachricht unkalibriert
2014-12-05 Bessere Anpassung des Displayfensters beim ST7565 Controller
2014-12-06 russische Doku und 8X16 Font
2014-12-20 I2C support for SSD1306, new ESR correction for low capacity
    [EE_check_init.c, Transistortester.h, autoconf.h, config.h, function_menu.c, lcd-routines.c, lcd_defines.h, main.c]
2014-12-20 Schutzdiode bei bipolaren Transistoren auch in der Graphik.
2014-12-21 Uebersetzung der Doku in russisch.
2015-01-25 Dokumentation der ESR-Messung mit 8us Pulsen
2015-01-26 Beschreibung der Programmierung ergaenzt
2015-01-27 russische Version der 370er Doku
2015-01-27 russische Version der 371er Doku und Korrektur der Doku
2015-01-30 Rechtschreibkorrektur der deutschen Doku von Mathias B.
2015-02-02 Beschreibung des Impulsdrehgeber Tests erweitert.
2015-02-03 Umstellung der lcd_clear funktion fuer ST7565 Controller
2015-02-03 russische Doku und korrekte I2C Schreibweise
2015-02-08 einige Korrekturen der 1.11k Doku
2015-02-08 Ergaenzung der 1.11k m328-Makefiles
2015-02-18 fixing the problem with the protection diode for ST7920
    [lcd-routines.c, lcd_defines.h, main.c]
2015-02-20 correcting wait time for character display controller
    [lcd-routines.c, lcd_defines.h]
2015-02-21 corrected 8x16 font, display refresh for ST7920 rotary e. check
    [CheckRotaryEncoder.c]
2015-02-24 H/V Flip with software, untested ST7108 support with 74HC164
    [AutoCheck.c, CheckRotaryEncoder.c, Transistortester.h, autoconf.h, config.h, lcd-routines.c, lcd-routines.h, lcd_defines.h]
2015-02-26 Correction of ST7108 circuit
2015-03-01 Organisation der graphischen Font-Daten gewechselt
2015-03-01 unbenutzte Teile der Font-Dateien entfernt, Dokumentation ergaenzt
2015-03-02 some corrections for cyrillic characterset support
    [lcd_defines.h]
2015-03-08 Makefile Problem mit russisch ohne LCD_CYRILLIC beseitigt
    [Transistortester.h, autoconf.h, bitmaps.h, config.h, lcd-routines.h, lcd_defines.h, tt_function.h]
2015-03-12 Neuanordnung von Icon und Messparametern auf graphischen Displays
2015-03-14 Neue Anordnung der Transistorparameter + Ic Ausgabe
2015-03-14 Uf der Schutzdiode von BJT ...
2015-03-17 automatischer Start der Kondensator und Widerstandsmessfunktion an TP1:TP3
2015-03-19 falsche Kennung des ESR bei C-Meter beseitigt.
2015-03-20 bei R-Meter Funktion wird ESR-Messung verhindert
2015-03-20 Korrektur der 78L05 Ausrichtung bei strip_grid Entwurf
2015-03-23 Resistor and capacity measurement without menu possible + documentation update
2015-03-26 ST7920 Korrektur, VBat check bei [RL] und [C], russische Doku
2015-03-28 Korrekturen und Optimierungen
2015-03-29 Korrektur ST7108 Anschluss und russische Doku
2015-04-06 Correction, enable frequency out arduino
    [function_menu.c]
2015-04-08 Wartezeit bei Ir Messung von Dioden verlaengert
2015-04-13 Berichtigung der C-Funktionen include
2015-04-13 russische Uebersetzung der Doku
2015-04-16 longer display time for low Battery, GetESR for mega2560
2015-04-18 mVAusgabe erlaubt Diodennummer kleiner 6
2015-04-23 correcting wrong IC4 connection of ATmega644 circuit
2015-05-10 Support for Chinese T5 board
2015-05-10 RDSon bei E-MOS wird genannt
2015-05-12 Beschreibung der chinesischen WEI_M8 Platine
2015-05-17 Beschreibung der chinesischen T4 Version
2015-05-22 Option LCD_ST7565_Y_START fuer Start Zeile des Displays
2015-08-27 Correction lcd_init for DOGM-163
    [lcd-routines.c, lcd_defines.h]
2015-08-29 mehr Zeilenwechsel und Leerzeichen bei serieller Ausgabe
2015-09-13 adding sample configuration for mega328_st7565_kit
2015-09-13 First part of the "sampling ADC" measurement code: - the actual sampling code - capacitance measurement (not yet calibration/subtraction of null capacity) - modification to DisplayValue.c to handle e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
2015-09-15 C_H_KORR can be set with menu Cap correction
    [ReadBigCap.c, ReadCapacity.c, Transistortester.h, function_menu.c, tt_function.h, tt_globals.h]
2015-09-15 SamplingADC capacitance measurements: - autocalibration - allow negative results - diode measurement: show capacitance both at low and high voltage to identify varicap
2015-09-16 sampling cap der Einzeldiode auch bei 2-Line
2015-09-16 Problem mit DC_pwr_mode beseitigt
    [function_menu.c, sampling_cap.c, show_Resis_Cap.c, tt_function.h]
2015-09-16 missing #if condition added.
    [show_Resis_Cap.c]
2015-09-16 Initalize the null capacitance values in EEPROM with reasonable defaults.
2015-09-17 Korrektur C uF -correction
    [Transistortester.h, function_menu.c]
2015-09-19 Fixed top line of [RL] mode for case of no coil detected, and for 20-char wide display.
    [Transistortester.h]
2015-09-20 Error in Battery_check, switch off
    [Battery_check.c]
2015-09-21 limit for L capacitor
2015-09-21 L capacitor EEprom
2015-09-23 Rewrite of the code displaying R and L results: - is now shared between main() and show_Resis_Cap() - also sampling L measurement between TP1:2 and TP2:3 - avoids flashing lcd by overwriting instead 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
    [Transistortester.h, lcd-routines.c, main.c, sampling_lc.c, show_Resis_Cap.c, tt_function.h]
2015-09-23 Save 30 bytes of flash by revising sorting of display data for 2 resistors.
2015-09-27 Slight simplification of [RL]-mode header line code; also repairs missing [R] if compiled without L-meter support.
    [Transistortester.h, lcd-routines.c, lcd-routines.h, show_Resis_Cap.c]
2015-09-28 Minor fix for [RL] mode first display line.
    [show_Resis_Cap.c]
2015-09-28 short uncalibrated message with option SHORT_UNCAL_MSG
    [HelpCalibration.c, ShowData.c, Transistortester.h, sampling_cap.c]
2015-09-30 Correction no ESR >1000uF
    [main.c, show_Resis_Cap.c]
2015-10-02 Ueberschreiben der Icons bei 6x8 Font
2015-10-03 Vak-Diodes problem with ILI9163,ST7735
    [lcd-routines.c]
2015-10-05 Correct of range check for graphical display
    [lcd-routines.c, main.c, sampling_cap.c]
2015-10-06 correction of wrong cyrillic fonts length
    [lcd_defines.h]
2015-10-13 8MHz version shows correct frequency with sampling_lc
    [sampling_lc.c]
2015-10-18 correction of middle menu entry
    [GetVloss.c, function_menu.c, main.c, sampling_cap.c, sampling_lc.c, show_Resis_Cap.c, sleep_5ms.c]
2015-10-19 Change of hFE/B switch
2015-11-03 Improvements to sampling_lc.c , adaptations for samplingADC_CNT, better sanity checks and prevent wrong dist0 calculation.
    [sampling_lc.c]
2015-11-06 Measure capacitance of double diode if compiled with samplingADC, since double diodes are often varicaps.
2015-11-11 New compile option #define big_cap_no_float enables 470 kOhm pull-up during ADC cycle in big cap measurement routine. This prevents detection of spurious big caps when in fact nothing is connected.
    [ReadCapacity.c]
2015-11-23 Rewrote samplingADC.S; now takes same arguments as samplingADC_cnt.S (which removed conditional code elsewhere), but has precisely periodic measurements and code is shorter.
    [config.h, main.c, sampling_cap.c, sampling_lc.c, tt_function.h]
2015-11-27 Tausch von Counter1 compare match Interrupts wegen samplingADC
2015-11-30 spezieller PWM-Modus fuer Modellbau Servo mit Option PWM_SERVO
2015-12-01 Correcting error of standard PWM with SVN version 614
    [autoconf.h, function_menu.c]
2015-12-01 spezieller PWM-Modus fuer Modellbau Servo, Anzeige Pulslaenge
2015-12-04 Fixed silly error in sampling_lc().
    [sampling_lc.c]
2016-01-02 Correction of missing Selection: without POWER_OFF option
    [GetResistance.c, Transistortester.h, autoconf.h, function_menu.c, sampling_lc.c]
2016-01-24 Ergaenzung der Beschreibung der SamplingADC Funktion
2016-02-17 Correction of crystal data output for 2-line display.
    [sampling_xtal.c]
2016-02-21 Abschalten des Testers nach Beenden des [C] oder [RL] Auto-Modus
2016-02-24 Fehlende Adresse in main.c ohne Option POWER_OFF
2016-02-24 Improvements to the crystal code: - only try crystals if cap < 100 pF - on weak crystal signals (typ. at high freq.), repeat 4 times and add to improve SNR - better sine approximation in minifourier(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
    [sampling_xtal.c]
2016-02-25 Self-initialize two variables to prevent warnings about them not being initialized properly (even though they provably are, conditionally in a loop).
    [sampling_xtal.c]
2016-02-26 Korrektur Overflow Problem bei hFE Bestimmung
    [CheckPins.c]
2016-03-02 Saved about 128 bytes of RAM and about 90 bytes of flash in xtal-measurements, by letting samplingADC() write 8-bit rather than 16-bit data. Also fixed incorrect aliasing of ceramic resonators.
    [config.h, sampling_cap.c, sampling_xtal.c, tt_function.h]
2016-03-07 Correction of f-generator problem without POWER_OFF
    [make_frequency.c]
2016-03-28 sure instead of shure correction
    [Calibrate_UR.c, ReadCapacity.c, config.h, lcd-routines.c, main.c]
2016-03-30 langsamere ISP-Clock fuer make fuses, fuses-crystal, erase
2016-04-21 Support for Arduino UNO
2016-04-22 Support for Arduino UNO, ReadMe
2016-04-22 wiring diagram for Arduino UNO shield
2016-04-22 Arduino UNO shield with LM4040
2016-04-23 Arduino UNO shield with LM4040 Correction
2016-05-08 Assembler-Version von optiboot mit EEprom
2016-08-01 correction for Arduino Uno shield
2016-08-23 Enable interruption by keypress of the ceramic resonator and crystal measurements, since they take a lot of time and can easily be started accidentally.
2016-12-17 function switch_tester_off
2016-12-25 correction of capacity limit for ESR mwasurement
2017-01-19 additional 470k resistor for the half amount of single ESR measurements
2017-01-19 Abschluss der 1.12k Version
2017-02-19 Ende der Frequenzerzeugung mit 2s Tastendruck
2017-03-28 Hardware Entwurf von Max
    [fritzing_sketch2.fzz]
2017-05-07 Anzeige der Cut-off Spannung bei JFET/D-MOS
2017-05-23 Made text "DC Pwr Mode" configurable from Makefile. (Useful e.g. for devices which use USB rather than an AC/DC power adapter.)
2017-05-23 Enable 470k resistor from HiPin to ground during pin discharge, to prevent not detecting completion of discharge if there's some leakage in the circuit (e.g., via protection diodes).
    [CheckPins.c]
2017-05-24 For JFETs only show cut-off voltage if measured value is not near 5 V (as then JFET may not really have been cut-off).
    Added measurement of I_{DSS} for JFET.
    Compliation onditional on #ifdef FET_Idss.
    So far only for N-channel, and output only on text display.
2017-05-26 zusaetzliche Tabellen der Anschlußbelegung
2017-05-27 neue russische Doku-Uebersetzung + Korrektur der englischen Doku
2017-05-27 Trivial corrections to source code comments.
    [CheckPins.c]
2017-07-26 corrections for Dutch language by D. Mantione
    [HelpCalibration.c, langDUTCH.h]
2017-08-13 support for ext voltage greater 63V possible
2017-12-13 new optiboot version with one wire serial support
2017-12-16 default hex for Arduino Sketch
2018-01-14 zusaetzlich m164p, m324p und m644p gestestet
2018-01-14 Bug reported from Cyril
    [lcd-routines-serial.c]
2018-01-15 negative LED_START_FLASHES bewirken RX Pin Test in der Schleife
2018-01-24 Check von HFUSE und LFUSE und weitere AVRs
2018-03-31 2. UART bei ATmega128 Familie
2018-04-02 NRWWSTART bei Assembler ohne UL
2018-04-05 UART Support for mega32U4 and mega32U2 family
2018-04-18 Correction of Danish language
    [function_menu.c, langDANISH.h]
2018-06-15 circuit for TC-1
2018-06-15 prevent the detection from defective electrolytic capacitor as diode
    [CheckPins.c]
2018-10-17 Fernsteuerung der m-Version, Widerstaende
2018-10-25 Fernsteuerung der m-Version, Kondensatoren
2018-10-30 Fernsteuerung der m-Version, Transistoren
2018-11-04 Fernsteuerung der m-Version, JFETs
2018-11-06 support for Chinese board hiland_m644
2020-03-03 hex und eep nach Project umbenannt von Gottfried
2020-05-03 PCB for ST7735 color display from Jose Miquel
2020-05-29 LC frequency error with 20MHz
    [sampling_lc.c]
2020-06-22 Build of optiboot with pin No and pin description from avr_pins/ files
2020-06-25 Anzeige der Pin Nummern bei LED,TX,RX
2020-06-25 Anzeige der unbenutzten Pin Nummer bei LED
2020-07-06 Neugestaltung mit erweiterten Option bei Auto-Baud und Software UART
2020-07-22 Korrektur der Ein-Pin UART Schaltung
2020-07-24 additional checks for correct FUSE settings
2020-07-25 Bildschirm-Kommentar und Makefile berichtigt
2020-07-28 Bild in Doku, TWO_STOP_BITS in SW-UART mit 3/2 Stop Bits
2021-02-03 corrected support for the T7 tester
    [config.h, lcd-routines.c]
2021-02-04 rotary encoder pins PD5,PD6 for the T7 tester
2021-02-19 Assembler version of Optiboot now at github kubi48/avr-assembler-optiboot
2021-02-24 Problem with 0x80 character solved, Czech Z_caron define corrected
    [lcd-routines.c]
2021-03-01 adding circuit of chinese TC1 multifunction tester
2021-03-14 Verbesserung der deutschen Linux Dokumentation
2021-05-08 Problem with PC3 input solved and some optimizing
    [autoconf.h, main.c, sleep_5ms.c, tt_function.h]
