Mikrocontroller-net/transistortester/(notices)

Notices in the files:
Software/trunk/autoconf.h:
CC0 defines the capacity of empty terminal pins 1 & 3 without cable
